bg6jji/MicroTransceiver/README.md

# MicroTransceiver

源项目地址https://github.com/threeme3/usdx

这是3波段电台的源代码，我修改了一些小细节

感谢Guido pe1nnz 以及DL2MAN,WB2CBA等为此项目作出的辛苦努力，并分享给大家。

主要项目如下：
+ 1、定义XMIT键，未来功能可能会定义为其他功能
+ 2、修改LPF继电器波段切换定义
+ 3、增加I/Q输出 和AUDIO切换继电器
+ 4、加入CW TONE音量调节
+ 5、调整编码器速度为2倍速

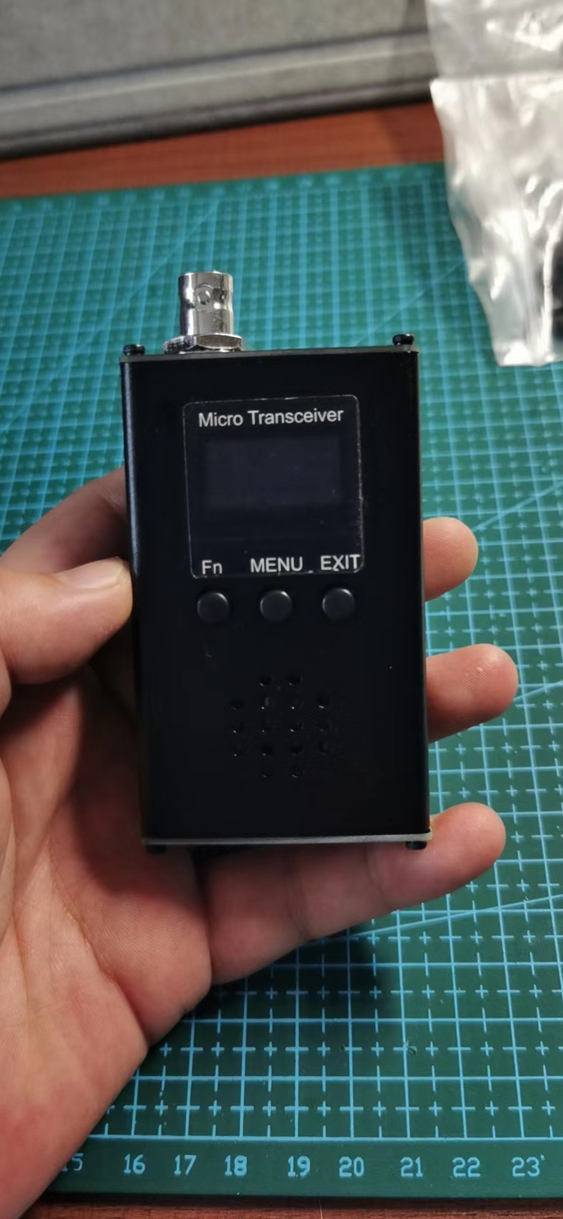
[picture p1: Photo/MicroTransceiver_bnc.jpg]
BNC接口的主机 BNC Connector
