bg6jji/MicroTransceiver/Photo/bottom side.jpg

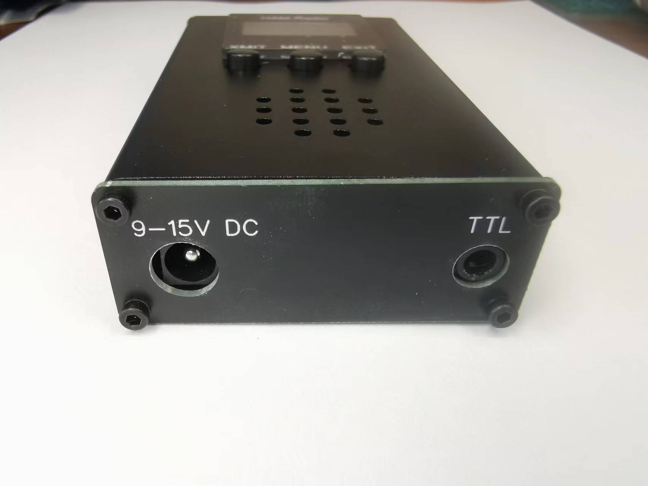
Photo/bottom side.jpg
