bg6jji/MicroTransceiver/Photo/front.jpg

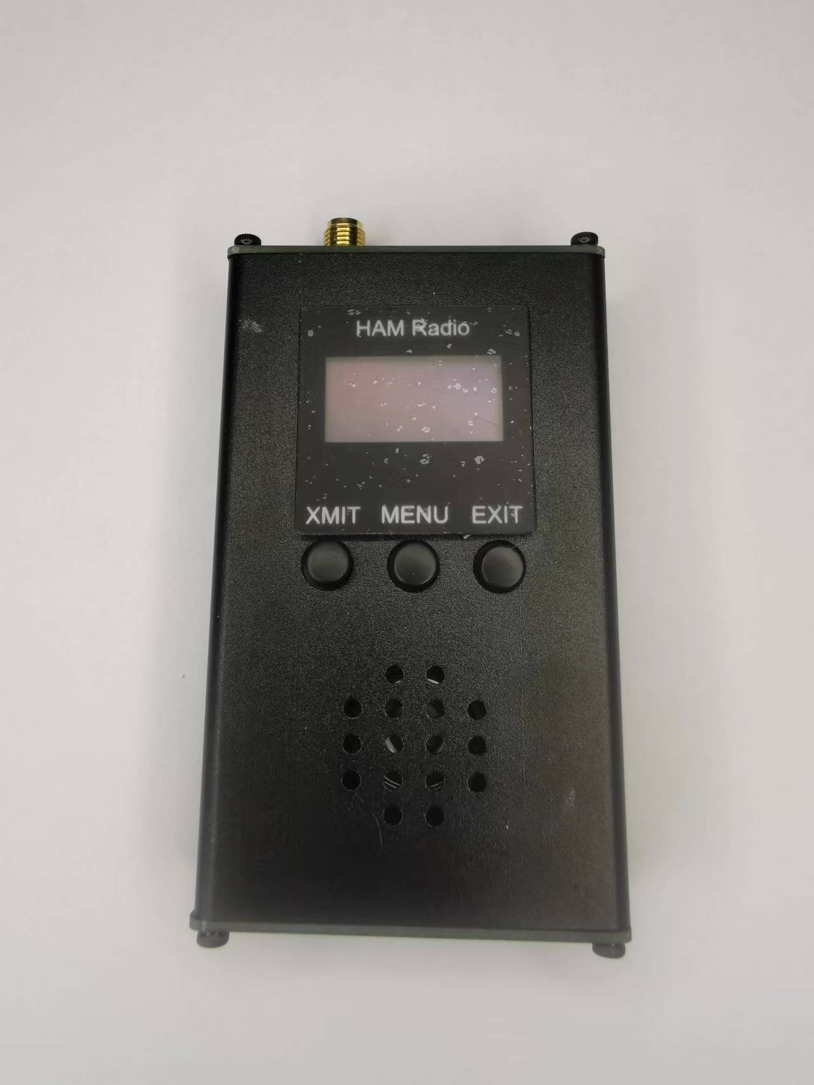
Photo/front.jpg
