bg6jji/MicroTransceiver/Photo/top side.jpg

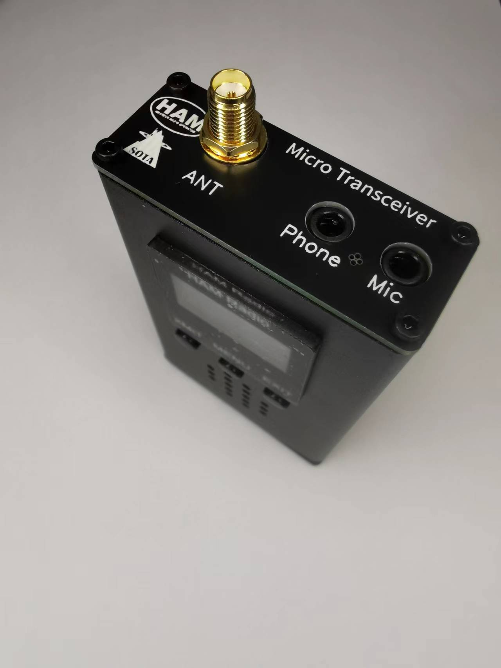
Photo/top side.jpg
