bg6jji/MicroTransceiver/Schematic/Schematic_Micro Transicever V3.3 furband_2022-09-26.pdf

# SI5351A

电源

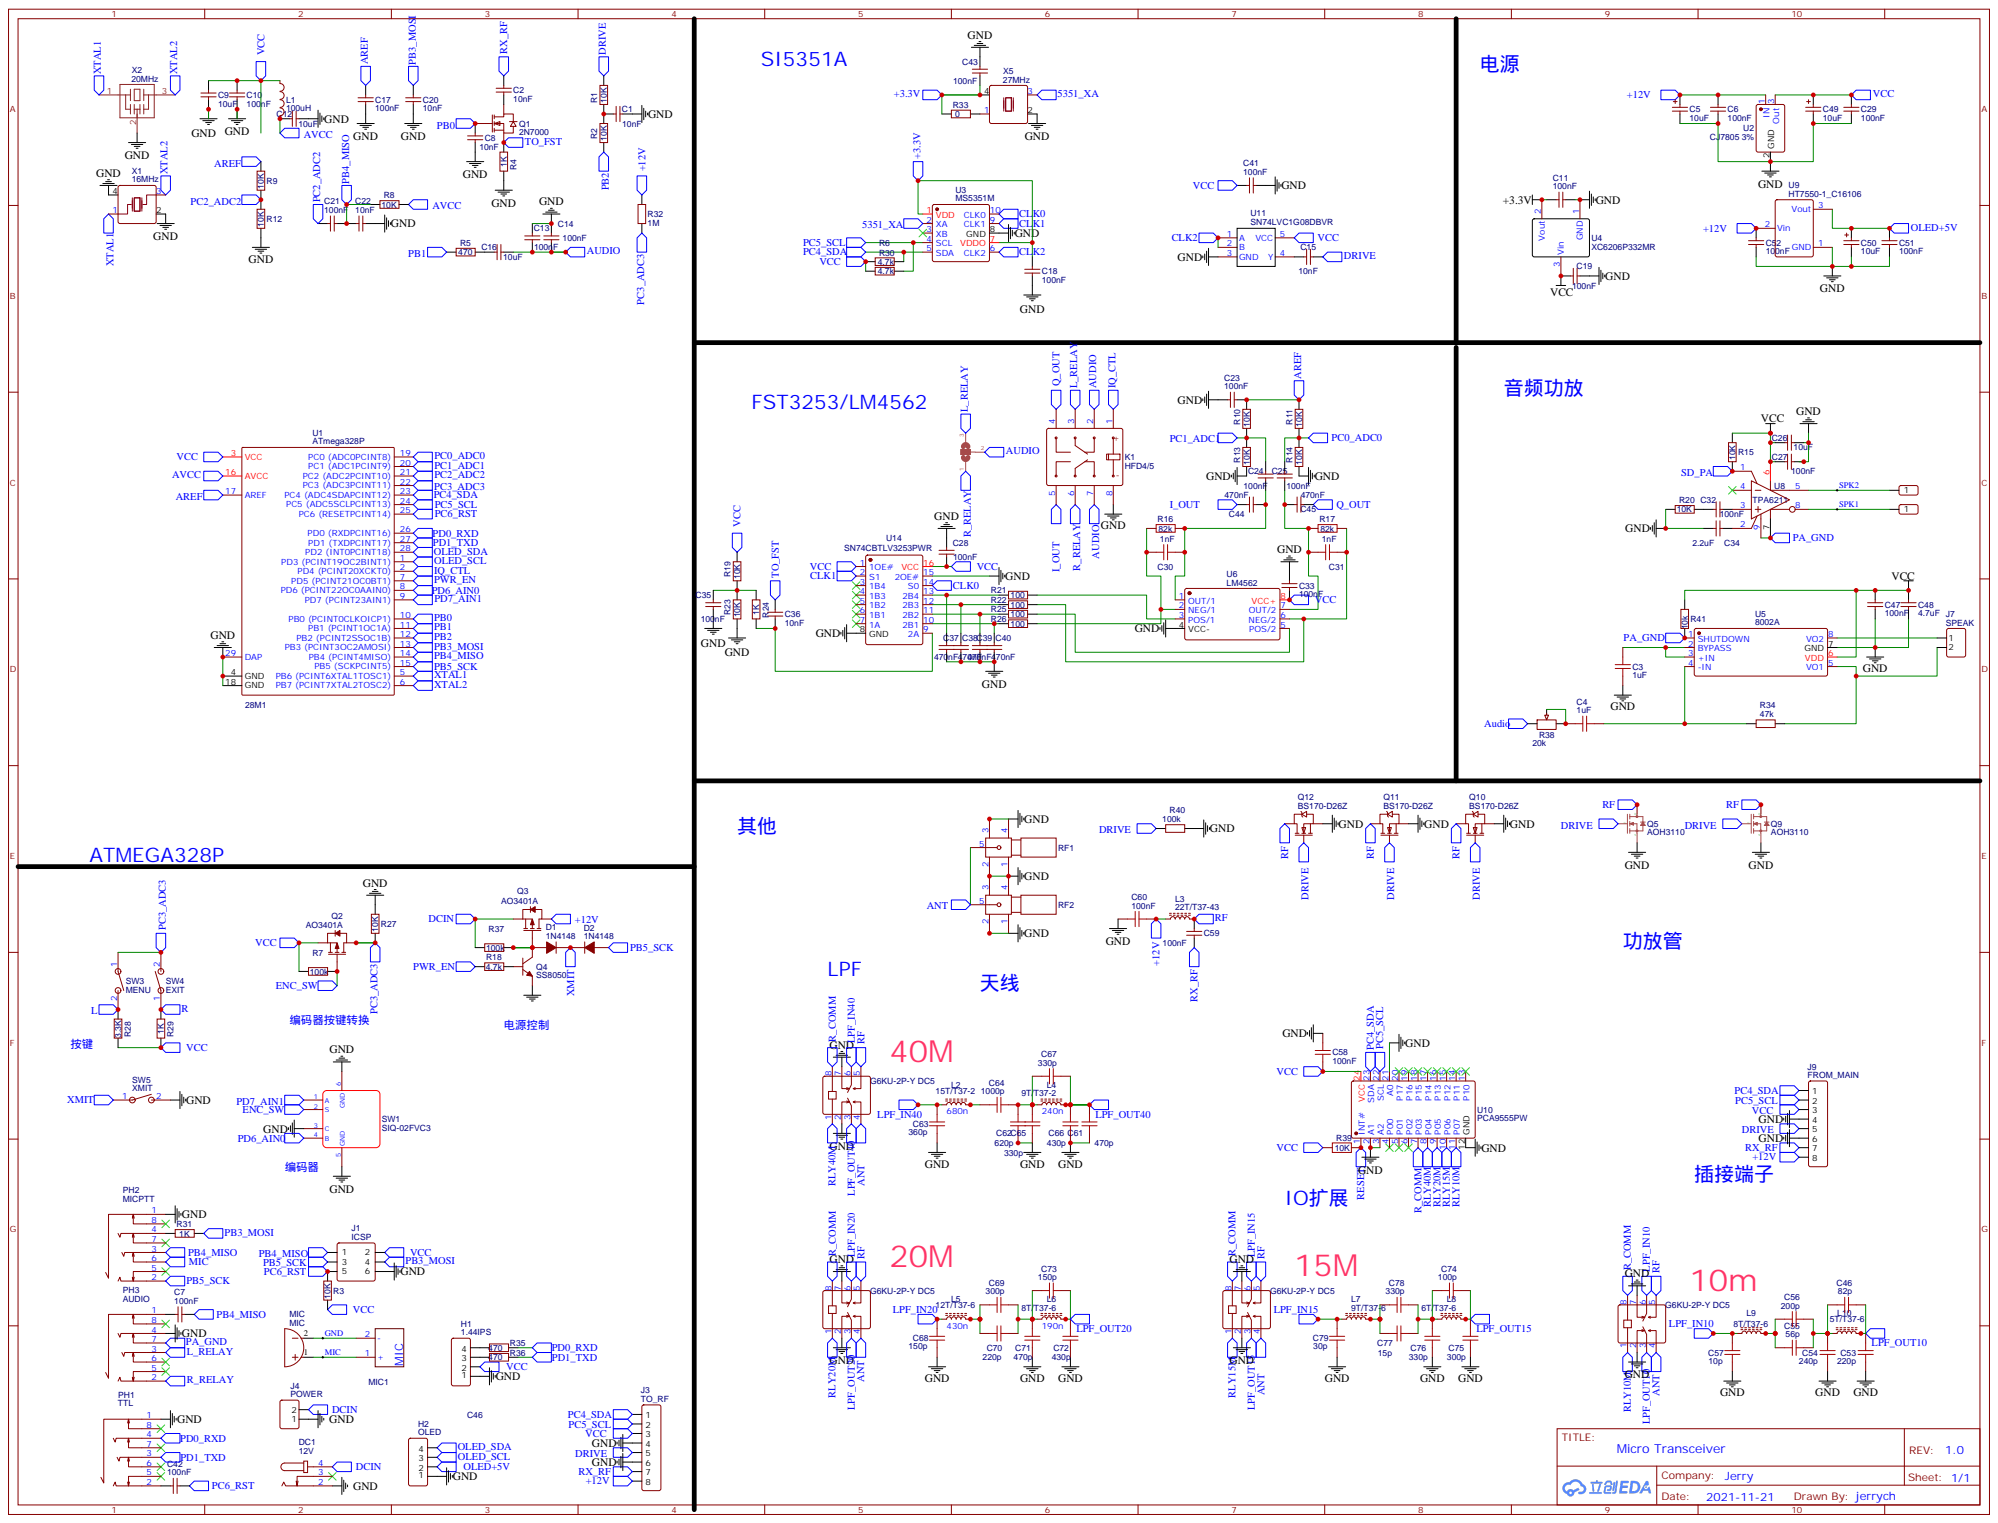
[picture p17: page 1]

GND 12 P10 13 P11 14 P12 15 P13 16 P14 17 P15 18 P16 19 P17 20 A0 21 SCL 22 SDA 23 VCC 24
