bg6jji/MicroTransceiver/Schematic/MicroTransceiver_3band_main_board_Schematic_2022-6-3.pdf

# SI5351A

电源

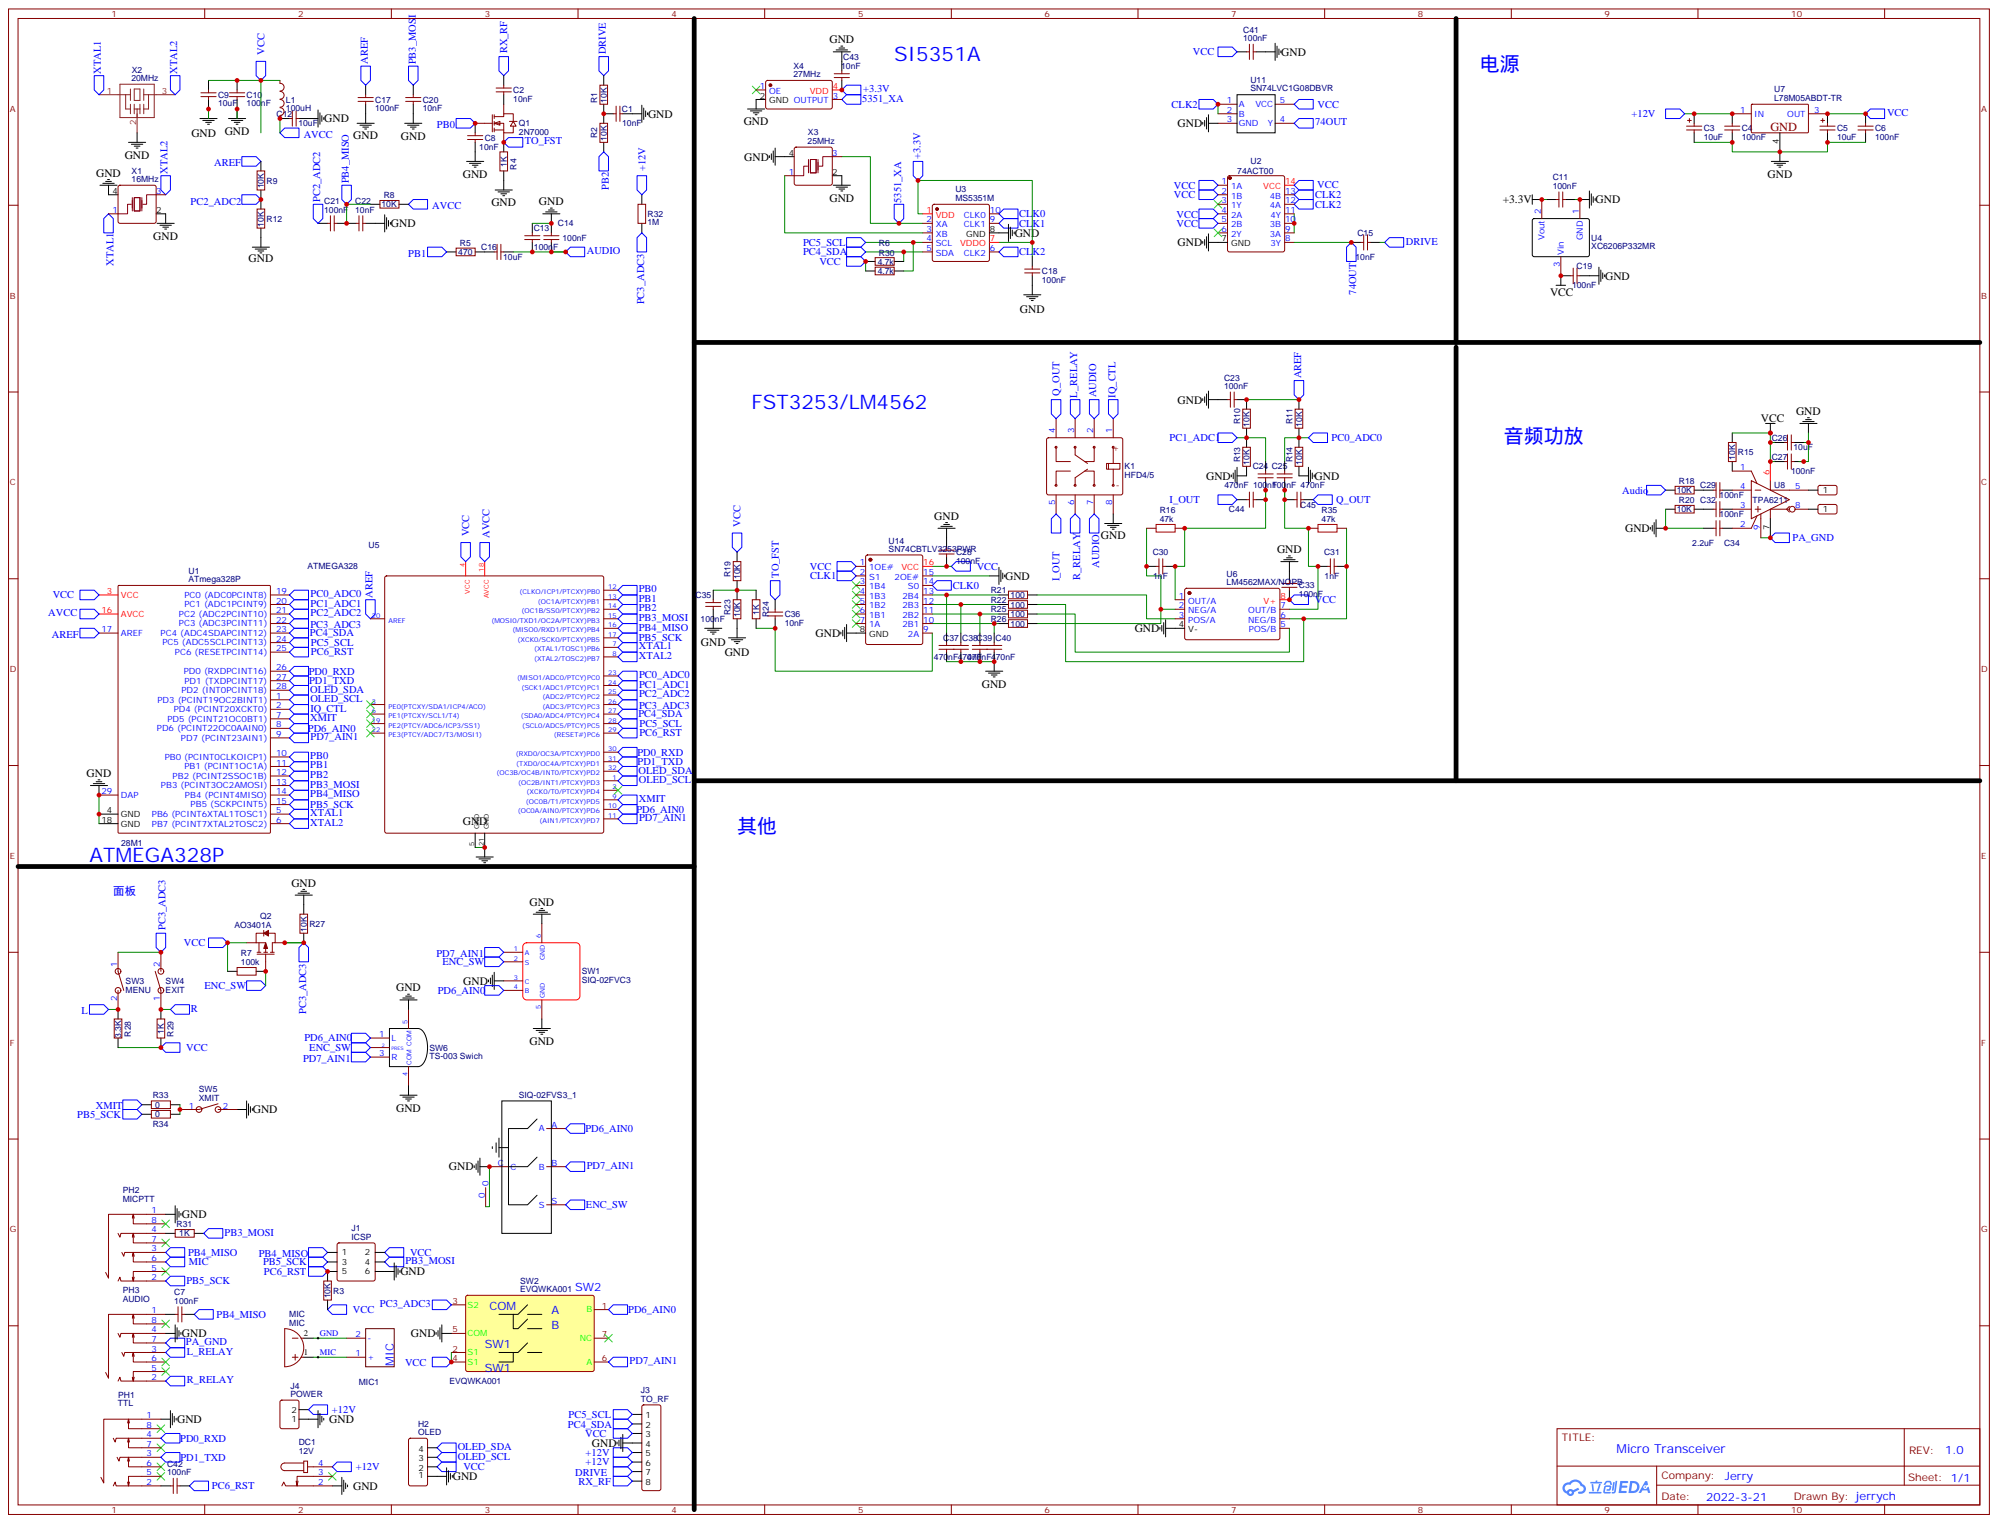
[picture p18: page 1]
