bg6jji/MicroTransceiver/Schematic/MicroTransceiver_3band_RF_board_Schematic_2022-6-3.pdf

20M | 15M | 40M

# 滤波器

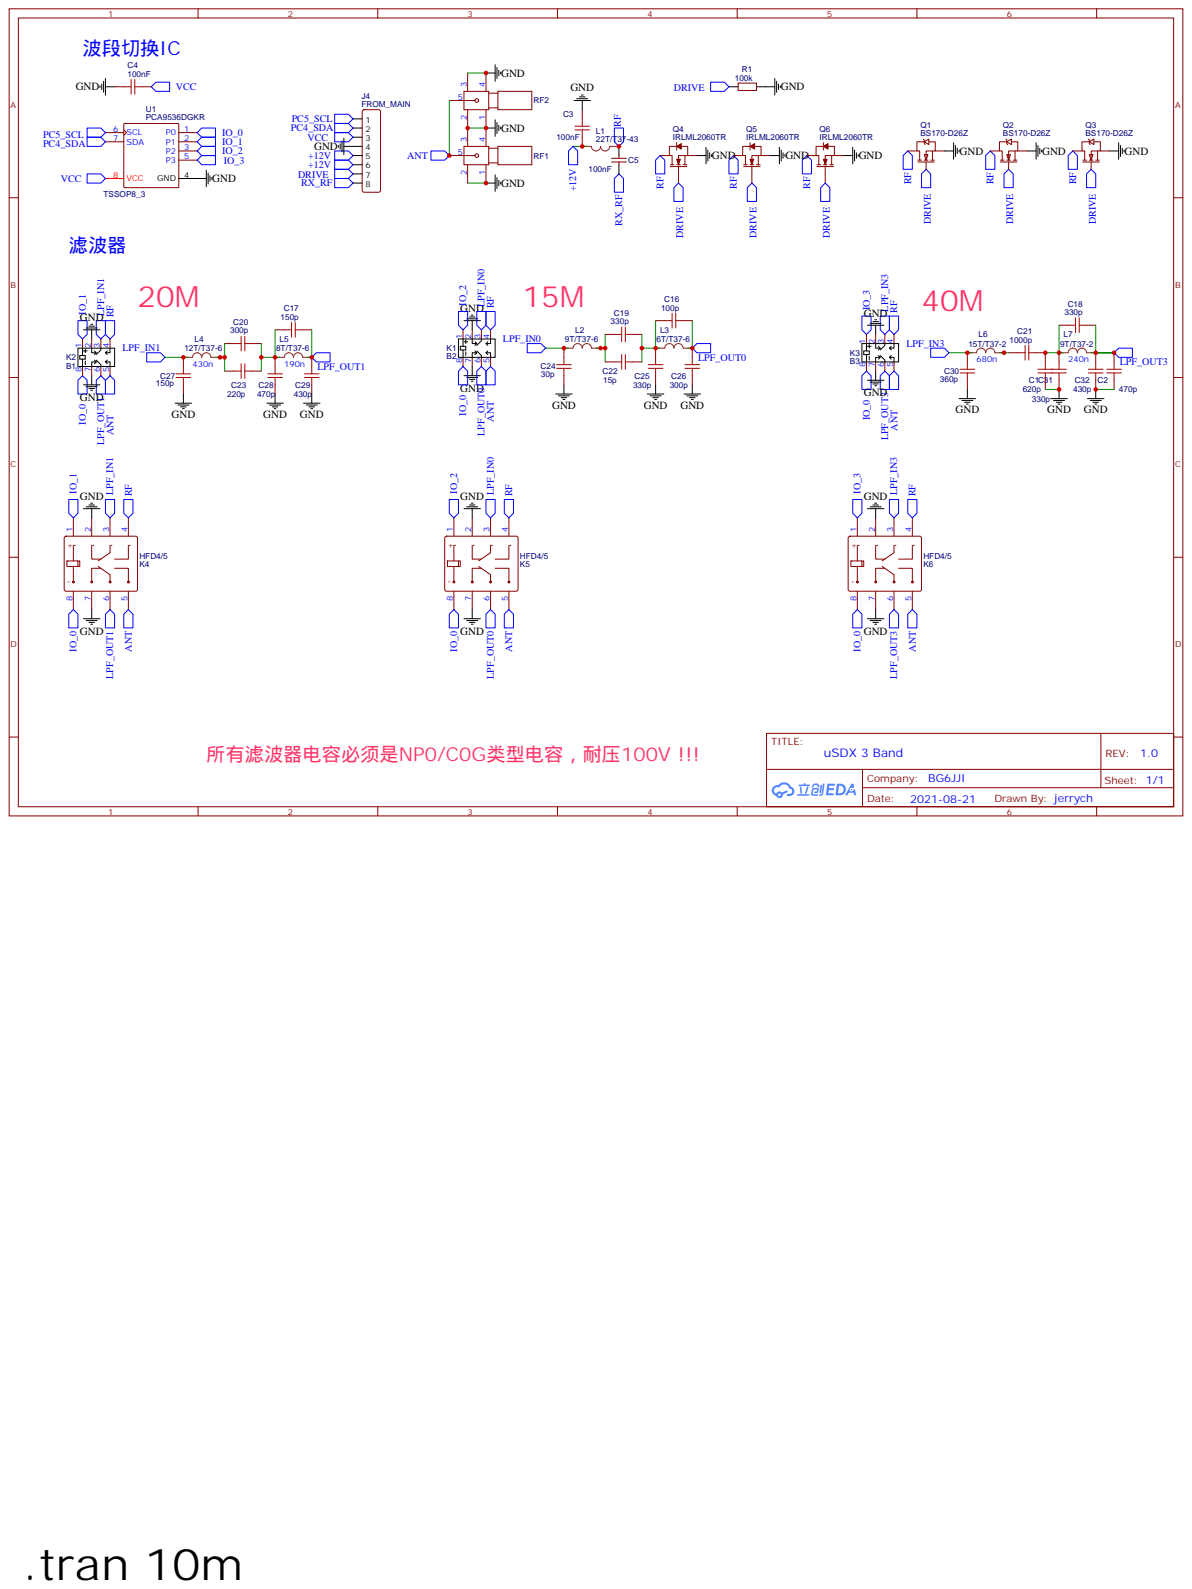
[picture p19: page 1]
