bg6jji/MicroTransceiver/MicroTransceiver3.4.ino

//  QCX-SSB.ino - https://github.com/threeme3/QCX-SSB
//
//  Copyright 2019, 2020, 2021   Guido PE1NNZ <pe1nnz@amsat.org>
//
//  Permission is hereby granted, free of charge, to any person obtaining a copy of this software and associated documentation files (the "Software"), to deal in the Software without restriction, including without limitation the rights to use, copy, modify, merge, publish, distribute, sublicense, and/or sell copies of the Software, and to permit persons to whom the Software is furnished to do so, subject to the following conditions: The above copyright notice and this permission notice shall be included in all copies or substantial portions of the Software. THE SOFTWARE IS PROVIDED "AS IS", WITHOUT WARRANTY OF ANY KIND, EXPRESS OR IMPLIED, INCLUDING BUT NOT LIMITED TO THE WARRANTIES OF MERCHANTABILITY, FITNESS FOR A PARTICULAR PURPOSE AND NONINFRINGEMENT. IN NO EVENT SHALL THE AUTHORS OR COPYRIGHT HOLDERS BE LIABLE FOR ANY CLAIM, DAMAGES OR OTHER LIABILITY, WHETHER IN AN ACTION OF CONTRACT, TORT OR OTHERWISE, ARISING FROM, OUT OF OR IN CONNECTION WITH THE SOFTWARE OR THE USE OR OTHER DEALINGS IN THE SOFTWARE.

#define VERSION   "1.02x"

// Configuration switches; remove/add a double-slash at line-start to enable/disable a feature; to save space disable e.g. CAT, DIAG, KEYER
//#define DIAG             1   // Hardware diagnostics on startup (only disable when your rig is working)
#define KEYER            1   // CW keyer
//#define CAT              1   // CAT-interface
#define F_XTAL  27000000   // 27MHz SI5351 crystal
//#define F_XTAL  25001000   // 25MHz SI5351 crystal  (enable for WB2CBA-uSDX, SI5351 break-out board or uSDXDuO)
//#define F_XTAL  25000000   // 25MHz SI5351 crystal  (enable for 25MHz TCXO)
#define SWAP_ROTARY    1   // Swap rotary direction (enable for WB2CBA-uSDX)
//#define QCX            1   // Supports older (non-SDR) QCX HW modifications (QCX, QCX-SSB, QCX-DSP with I/Q alignment-feature)
#define OLED_SSD1306   1   // OLED display (SSD1306 128x32 or 128x64), connect SDA (PD2), SCL (PD3)
//#define OLED_SH1106    1   // OLED display (SH1106 1.3" inch display), connect SDA (PD2), SCL (PD3), NOTE that this display is pretty slow
//#define LCD_I2C        1   // LCD with I2C (PCF8574 module          ), connect SDA (PD2), SCL (PD3), NOTE that this display is pretty slow
//#define LPF_SWITCHING_DL2MAN_USDX_REV3           1   // Enable 8-band filter bank switching:     latching relays wired to a TCA/PCA9555 GPIO extender on the PC4/PC5 I2C bus; relays are using IO0.0 as common (ground), IO1.0..7 used by the individual latches K0-7 switching respectively LPFs for 10m, 15m, 17m, 20m, 30m, 40m, 60m, 80m
//#define LPF_SWITCHING_DL2MAN_USDX_REV3_NOLATCH 1   // Enable 8-band filter bank switching: non-latching relays wired to a TCA/PCA9555 GPIO extender on the PC4/PC5 I2C bus; relays are using IO0.0 as common (ground), IO1.0..7 used by the individual latches K0-7 switching respectively LPFs for 10m, 15m, 17m, 20m, 30m, 40m, 60m, 80m. Enable this if you are using 8-band non-latching version for the relays, the radio will draw extra 15mA current but will work ity any relay (Tnx OH2UDS/TA7W Baris)
#define LPF_SWITCHING_DL2MAN_USDX_REV2         1   // Enable 5-band filter bank switching:     latching relays wired to a TCA/PCA9555 GPIO extender on the PC4/PC5 I2C bus; relays are using IO0.1 as common (ground), IO0.3, IO0.5, IO0.7, IO1.1, IO1.3 used by the individual latches K1-5 switching respectively LPFs for 20m, 30m, 40m, 60m, 80m
// #define LPF_SWITCHING_DL2MAN_USDX_REV2_BETA    1   // Enable 5-band filter bank switching:     latching relays wired to a PCA9539PW   GPIO extender on the PC4/PC5 I2C bus; relays are using IO0.1 as common (ground), IO0.3, IO0.5, IO0.7, IO1.1, IO1.3 used by the individual latches K1-5 switching respectively LPFs for 20m, 30m, 40m, 60m, 80m
// #define LPF_SWITCHING_DL2MAN_USDX_REV1         1   // Enable 3-band filter bank switching:     latching relays wired to a PCA9536D    GPIO extender on the PC4/PC5 I2C bus; relays are using IO0 as common (ground), IO1-IO3 used by the individual latches K1-3 switching respectively LPFs for 20m, 40m, 80m
//#define LPF_SWITCHING_WB2CBA_USDX_OCTOBAND     1   // Enable 8-band filter bank switching: non-latching relays wired to a MCP23008    GPIO extender on the PC4/PC5 I2C bus; relays are using GND as common (ground), GP0..7 used by the individual latches K1-8 switching respectively LPFs for 80m, 60m, 40m, 30m, 20m, 17m, 15m, 10m
//#define LPF_SWITCHING_PE1DDA_USDXDUO           14  // Enable 2-band filter bank switching: non-latching relay  wired to pin PD5 (pin 11); specify as value the frequency in MHz for which (and above) the relay should be altered (e.g. put 14 to enable the relay at 14MHz and above to use the 20m LPF).
#define SI5351_ADDR   0x60   // SI5351A I2C address: 0x60 for SI5351A-B-GT, Si5351A-B04771-GT, MS5351M; 0x62 for SI5351A-B-04486-GT; 0x6F for SI5351A-B02075-GT; see here for other variants: https://www.silabs.com/TimingUtility/timing-download-document.aspx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
#define F_MCU   16000000   // 16MHz ATMEGA328P crystal (enable for unmodified Arduino Uno/Nano boards with 16MHz crystal). You may change this value to any other crystal frequency (up to 28MHz may work)

// Advanced configuration switches
//#define CONDENSED      1   // Display in 4 line mode (for OLED and LCD2004 modules)
//#define CAT_EXT        1   // Extended CAT support: remote button and screen control commands over CAT
//#define CAT_STREAMING  1   // Extended CAT support: audio streaming over CAT, once enabled and triggered with CAT cmd, samplerate 7812Hz, 8-bit unsigned audio is sent over UART. The ";" is omited in the data-stream, and only sent to indicate the beginning and end of a CAT cmd.
#define CW_DECODER       1   // CW decoder
#define TX_ENABLE        1   // Disable this for RX only (no transmit), e.g. to support uSDX for kids idea: https://groups.io/g/ucx/topic/81030243#6276
#define KEY_CLICK        1   // Reduce key clicks by envelope shaping
#define SEMI_QSK         1   // Just after keying the transmitter, keeps the RX muted for a short amount of time in the anticipation for continued keying
#define RIT_ENABLE       1   // Receive-In-Transit alternates the receiving frequency with an user-defined offset to compensate for any necessary tuning needed on receive
#define VOX_ENABLE       1   // Voice-On-Xmit which is switching the transceiver into transmit as soon audio is detected (above noise gate level)
#define MOX_ENABLE     1   // Monitor-On-Xmit which is audio monitoring on speaker during transmit
#define FAST_AGC       1   // Adds fast AGC option (good for CW)
#define VSS_METER      1   // Supports Vss measurement (as s-meter option), requires resistor of 1M between 12V and pin 26 (PC3)
//#define SWR_METER      1   // Supports SWR meter with bridge on A6/A7 (LQPF ATMEGA328P) by Alain, K1FM, see: https://groups.io/g/ucx/message/6262 and https://groups.io/g/ucx/message/6361
//#define ONEBUTTON      1   // Use single (encoder) button to control full the rig; optionally use L/R buttons to completely replace rotory encoder function
//#define DEBUG          1   // for development purposes only (adds debugging features such as CPU, sample-rate measurement, additional parameters)
//#define TESTBENCH      1   // Tests RX chain by injection of sine wave, measurements results are sent over serial
// #define CW_FREQS_QRP   1   // Defaults to CW QRP   frequencies when changing bands
//#define CW_FREQS_FISTS 1   // Defaults to CW FISTS frequencies when changing bands
#define CW_MESSAGE       1   // Transmits pre-defined CW messages on-demand (left-click menu item 4.2)
//#define CW_MESSAGE_EXT 1   // Additional CW messages
//#define TX_DELAY       1   // Enables a delay in the actual transmission to allow relay-switching to be completed before the power is applied (see also NTX, PTX definitions below for GPIO that can switch relay/PA)
#define NTX            11  // Enables LOW  on TX, used as PTT out to enable external PAs (a value of 11 means PB3 is used)
//#define PTX            11  // Enables HIGH on TX, used as PTT out to enable external PAs (a value of 11 means PB3 is used)
//#define CLOCK          1   // Enables clock
//#define CW_INTERMEDIATE  1   // CW decoder shows intermediate characters (only available for LCD and F_MCU at 20M), sequences like:  EIS[HV] EIUF EAW[JP] EARL TMO TMG[ZQ] TND[BX] TNK[YC], may be good to learn CW; a full list of possible sequences:  EISH5 EISV3 EIUF EIUU2 EAWJ1 EAWP EARL TMOO0 TMOO9 TMOO8 TMGZ7 TMGQ TNDB6 TNDX TNKY TNKC
//#define F_XTAL  20000000   // Enable this for uSDXDuO, 20MHz SI5351 crystal
//#define TX_CLK0_CLK1   1   // Enable this for uSDXDuO, i.e. when PA is driven by CLK0, CLK1 (not CLK2); NTX pin may be used for enabling the TX path (this is like RX pin, except that RX may also be used as attenuator)
//#define F_CLK2  12000000   // Enables a fixed CLK2 clock output of choice (only applicable when TX_CLK0_CLK1 is enabled), e.g. for up-converter or to clock UART USB device



// QCX pin defintions
#define LCD_D4  0         //PD0    (pin 2)
#define LCD_D5  1         //PD1    (pin 3)
#define LCD_D6  2         //PD2    (pin 4)
#define LCD_D7  3         //PD3    (pin 5)
#define LCD_EN  4         //PD4    (pin 6)
#define FREQCNT 5         //PD5    (pin 11)
#define ROT_A   6         //PD6    (pin 12)
#define ROT_B   7         //PD7    (pin 13)
#define RX      8         //PB0    (pin 14)
#define SIDETONE 9        //PB1    (pin 15)
#define KEY_OUT 10        //PB2    (pin 16)
#define SIG_OUT 11        //PB3    (pin 17)
#define DAH     12        //PB4    (pin 18)
#define DIT     13        //PB5    (pin 19)
#define AUDIO1  15        //PC0/A0 (pin 23)
#define AUDIO2  14        //PC1/A1 (pin 24)
#define DVM     16        //PC2/A2 (pin 25)
#define BUTTONS 17        //PC3/A3 (pin 26)
#define LCD_RS  18        //PC4    (pin 27)
#define SDA     18        //PC4    (pin 27)
#define SCL     19        //PC5    (pin 28)
//#define NTX   11        //PB3    (pin 17)
//#define PTX   11        //PB3    (pin 17)

#define XMIT     5        //PD5    
#define IQOUT   4         //PD4    
#ifdef SWAP_ROTARY
#undef ROT_A
#undef ROT_B
#define ROT_A   7         //PD7    (pin 13)
#define ROT_B   6         //PD6    (pin 12)
#endif

#if (defined(OLED_SSD1306) || defined(OLED_SH1106))
#define OLED    1
#endif

#if (defined(CAT) || defined(TESTBENCH)) && !(OLED)
#define _SERIAL  1       // Coexistence support for serial port and LCD on the same pins
#endif

#ifdef LPF_SWITCHING_DL2MAN_USDX_REV3_NOLATCH
#define LPF_SWITCHING_DL2MAN_USDX_REV3         1
#endif

#ifdef TX_CLK0_CLK1
#ifdef F_CLK2
#define TX1RX0  0b11111000
#define TX1RX1  0b11111000
#define TX0RX1  0b11111000
#define TX0RX0  0b11111011
#else //!F_CLK2
#define TX1RX0  0b11111100
#define TX1RX1  0b11111100
#define TX0RX1  0b11111100
#define TX0RX0  0b11111111
#endif //F_CLK2
#else  //!TX_CLK0_CLK1
#define TX1RX0  0b11111011
#define TX1RX1  0b11111000
#define TX0RX1  0b11111100
#define TX0RX0  0b11111111
#endif //TX_CLK0_CLK1

#if defined(F_CLK2) && !defined(TX_CLK0_CLK1)
#error "TX_CLK0_CLK1 must be enabled in order to use F_CLK2."
#endif

#ifndef TX_ENABLE
#undef KEYER
#undef TX_DELAY
#undef SEMI_QSK
#undef RIT_ENABLE
#undef VOX_ENABLE
#undef MOX_ENABLE
#endif //!TX_ENABLE

#ifdef SWR_METER
float FWD;
float SWR;
float ref_V = 5 * 1.15;
static uint32_t stimer;
#define PIN_FWD  A6
#define PIN_REF  A7
#endif

/*
  // UCX installation: On blank chip, use (standard Arduino Uno) fuse settings (E:FD, H:DE, L:FF), and use customized Optiboot bootloader for 20MHz clock, then upload via serial interface (with RX, TX and DTR lines connected to pin 1, 2, 3 respectively)
  // UCX pin defintions
  +#define SDA     3         //PD3    (pin 5)
  +#define SCL     4         //PD4    (pin 6)
  +#define ROT_A   6         //PD6    (pin 12)
  +#define ROT_B   7         //PD7    (pin 13)
  +#define RX      8         //PB0    (pin 14)
  +#define SIDETONE 9        //PB1    (pin 15)
  +#define KEY_OUT 10        //PB2    (pin 16)
  +#define NTX     11        //PB3    (pin 17)
  +#define DAH     12        //PB4    (pin 18)
  +#define DIT     13        //PB5    (pin 19)
  +#define AUDIO1  14        //PC0/A0 (pin 23)
  +#define AUDIO2  15        //PC1/A1 (pin 24)
  +#define DVM     16        //PC2/A2 (pin 25)
  +#define BUTTONS 17        //PC3/A3 (pin 26)
  // In addition set:
  #define OLED  1
  #define ONEBUTTON  1
  #define ONEBUTTON_INV 1
  #undef DEBUG
  adjust I2C and I2C_ ports,
  ssb_cap=1; dsp_cap=2;
  #define _DELAY() for(uint8_t i = 0; i != 5; i++) asm("nop");
  #define F_XTAL 20004000
  #define F_CPU F_XTAL
*/

//FUSES = { .low = 0xFF, .high = 0xD6, .extended = 0xFD };   // Fuse settings should be set at programming (Arduino IDE > Tools > Burn bootloader)

#if(ARDUINO < 10810)
#error "Unsupported Arduino IDE version, use Arduino IDE 1.8.10 or later from https://www.arduino.cc/en/software"
#endif
#if !(defined(ARDUINO_ARCH_AVR))
#error "Unsupported architecture, select Arduino IDE > Tools > Board > Arduino AVR Boards > Arduino Uno."
#endif
//#if(F_CPU != 16000000)
//   #error "Unsupported clock frequency, Arduino IDE must specify 16MHz clock; alternate crystal frequencies may be specified with F_MCU."
//#endif
#undef F_CPU
#define F_CPU 20007000  // Actual crystal frequency of 20MHz XTAL1, note that this declaration is just informative and does not correct the timing in Arduino functions like delay(); hence a 1.25 factor needs to be added for correction.
#ifndef F_MCU
#define F_MCU 20000000  // 20MHz ATMEGA328P crystal
#endif

extern char __bss_end;
static int freeMemory() {
  char* sp = reinterpret_cast<char*>(SP);  // see: http://www.nongnu.org/avr-libc/user-manual/malloc.html
  return sp - &__bss_end;
}

#ifdef CAT_EXT
volatile uint8_t cat_key = 0;
uint8_t _digitalRead(uint8_t pin) { // reads pin or (via CAT) artificially overriden pins
  serialEvent();  // allows CAT update
  if (cat_key) {
    return (pin == BUTTONS) ? ((cat_key & 0x07) > 0) : (pin == DIT) ? ~cat_key & 0x10 : (pin == DAH) ? ~cat_key & 0x20 : 0;  // overrides digitalRead(DIT, DAH, BUTTONS);
  }
  return digitalRead(pin);
}
#else
#define _digitalRead(x) digitalRead(x)
#endif //CAT_EXT

//#define ONEBUTTON_INV 1 // Encoder button goes from PC3 to GND (instead PC3 to 5V, with 10k pull down)
#ifdef ONEBUTTON_INV
uint8_t inv = 1;
#else
uint8_t inv = 0;
#endif

//#ifdef KEYER
// Iambic Morse Code Keyer Sketch, Contribution by Uli, DL2DBG. Copyright (c) 2009 Steven T. Elliott Source: http://openqrp.org/?p=343,  Trimmed by Bill Bishop - wrb[at]wrbishop.com.  This library is free software; you can redistribute it and/or modify it under the terms of the GNU Lesser General Public License as published by the Free Software Foundation; either version 2.1 of the License, or (at your option) any later version. This library is distributed in the hope that it will be useful, but WITHOUT ANY WARRANTY; without even the implied warranty of MERCHANTABILITY or FITNESS FOR A PARTICULAR PURPOSE.  See the GNU Lesser General Public License for more details: Free Software Foundation, Inc., 59 Temple Place, Suite 330, Boston, MA  02111-1307  USA.

// keyerControl bit definitions
#define DIT_L    0x01     // Dit latch
#define DAH_L    0x02     // Dah latch
#define DIT_PROC 0x04     // Dit is being processed
#define PDLSWAP  0x08     // 0 for normal, 1 for swap
#define IAMBICB  0x10     // 0 for Iambic A, 1 for Iambic B
#define IAMBICA  0x00     // 0 for Iambic A, 1 for Iambic B
#define SINGLE   2        // Keyer Mode 0 1 -> Iambic2  2 ->SINGLE

int keyer_speed = 25;
static unsigned long ditTime;                    // No. milliseconds per dit
static uint8_t keyerControl;
static uint8_t keyerState;
static uint8_t keyer_mode = 2; //->  SINGLE
static uint8_t keyer_swap = 0; //->  DI/DAH

static uint32_t ktimer;
static int Key_state;
int debounce;

enum KSTYPE {IDLE, CHK_DIT, CHK_DAH, KEYED_PREP, KEYED, INTER_ELEMENT }; // State machine states

void update_PaddleLatch() // Latch dit and/or dah press, called by keyer routine
{
  if (_digitalRead(DIT) == LOW) {
    keyerControl |= keyer_swap ? DAH_L : DIT_L;
  }
  if (_digitalRead(DAH) == LOW) {
    keyerControl |= keyer_swap ? DIT_L : DAH_L;
  }
}

void loadWPM (int wpm) // Calculate new time constants based on wpm value
{
#if(F_MCU != 20000000)
  ditTime = (1200ULL * F_MCU / 16000000) / wpm; //ditTime = 1200/wpm;  compensated for F_CPU clock (running in a 16MHz Arduino environment)
#else
  ditTime = (1200 * 5 / 4) / wpm; //ditTime = 1200/wpm;  compensated for 20MHz clock (running in a 16MHz Arduino environment)
#endif
}
//#endif //KEYER
static uint8_t practice = false;  // Practice mode

volatile uint8_t cat_active = 0;
volatile uint32_t rxend_event = 0;
volatile uint8_t vox = 0;

#include <avr/sleep.h>
#include <avr/wdt.h>

//#define _I2C_DIRECT_IO    1 // Enables communications that is not using the standard I/O pull-down approach with pull-up resistors, instead I/O is directly driven with 0V/5V
class I2C_ { // Secundairy I2C class used by I2C LCD/OLED, uses alternate pins: PD2 (SDA) and PD3 (SCL)
  public:

#if(F_MCU > 20900000)
#ifdef OLED_SH1106
#define _DELAY() for(uint8_t i = 0; i != 9; i++) asm("nop");
#else
#ifdef OLED_SSD1306
#define _DELAY() for(uint8_t i = 0; i != 6; i++) asm("nop");
#else // other (I2C_LCD)
#define _DELAY() for(uint8_t i = 0; i != 7; i++) asm("nop");
#endif
#endif
#else // slow F_MCU
#ifdef OLED_SH1106
#define _DELAY() for(uint8_t i = 0; i != 8; i++) asm("nop");
#else
#ifdef OLED_SSD1306
#define _DELAY() for(uint8_t i = 0; i != 4; i++) asm("nop"); // 4=731kb/s
#else // other (I2C_LCD)
#define _DELAY() for(uint8_t i = 0; i != 5; i++) asm("nop");
#endif
#endif
#endif // F_MCU
#define _I2C_SDA (1<<2) // PD2
#define _I2C_SCL (1<<3) // PD3
#ifdef _I2C_DIRECT_IO
#define _I2C_INIT() _I2C_SDA_HI(); _I2C_SCL_HI(); DDRD |= (_I2C_SDA | _I2C_SCL);  // direct I/O (no need for pull-ups)
#define _I2C_SDA_HI() PORTD |=  _I2C_SDA;
#define _I2C_SDA_LO() PORTD &= ~_I2C_SDA;
#define _I2C_SCL_HI() PORTD |=  _I2C_SCL; _DELAY();
#define _I2C_SCL_LO() PORTD &= ~_I2C_SCL; _DELAY();
#else // !_I2C_DIRECT_IO
#define _I2C_INIT()   PORTD &= ~_I2C_SDA; PORTD &= ~_I2C_SCL; _I2C_SDA_HI(); _I2C_SCL_HI();  // open-drain
#define _I2C_SDA_HI() DDRD &= ~_I2C_SDA;
#define _I2C_SDA_LO() DDRD |=  _I2C_SDA;
#define _I2C_SCL_HI() DDRD &= ~_I2C_SCL; _DELAY();
#define _I2C_SCL_LO() DDRD |=  _I2C_SCL; _DELAY();
#endif // !_I2C_DIRECT_IO
#define _I2C_START() _I2C_SDA_LO(); _DELAY(); _I2C_SCL_LO(); // _I2C_SDA_HI();
#define _I2C_STOP()  _I2C_SDA_LO(); _I2C_SCL_HI(); _I2C_SDA_HI();
#define _I2C_SUSPEND() //_I2C_SDA_LO(); // SDA_LO to allow re-use as output port
#define _SendBit(data, bit) \
  if(data & 1 << bit){ \
    _I2C_SDA_HI();  \
  } else {         \
    _I2C_SDA_LO();  \
  }                \
  _I2C_SCL_HI();    \
  _I2C_SCL_LO();
    inline void start() {
      _I2C_INIT();
      _I2C_START();
    };
    inline void stop() {
      _I2C_STOP();
      _I2C_SUSPEND();
    };
    inline void SendByte(uint8_t data) {
      _SendBit(data, 7);
      _SendBit(data, 6);
      _SendBit(data, 5);
      _SendBit(data, 4);
      _SendBit(data, 3);
      _SendBit(data, 2);
      _SendBit(data, 1);
      _SendBit(data, 0);
      _I2C_SDA_HI();  // recv ACK
      _DELAY(); //
      _I2C_SCL_HI();
      _I2C_SCL_LO();
    }
    void SendRegister(uint8_t addr, uint8_t* data, uint8_t n) {
      start();
      SendByte(addr << 1);
      while (n--) SendByte(*data++);
      stop();
    }
    //void SendRegister(uint8_t addr, uint8_t val){ SendRegister(addr, &val, 1); }

    void begin() {};
    void beginTransmission(uint8_t addr) {
      start();
      SendByte(addr << 1);
    };
    bool write(uint8_t byte) {
      SendByte(byte);
      return 1;
    };
    uint8_t endTransmission() {
      stop();
      return 0;
    };
};
I2C_ Wire;
//#include <Wire.h>

uint8_t backlight = 8; 
//#define RS_HIGH_ON_IDLE   1   // Experimental LCD support where RS line is high on idle periods to comply with SDA I2C standard.

class LCD : public Print {  // inspired by: http://www.technoblogy.com/show?2BET
  public:  // LCD1602 display in 4-bit mode, RS is pull-up and kept low when idle to prevent potential display RFI via RS line
#define _dn  0      // PD0 to PD3 connect to D4 to D7 on the display
#define _en  4      // PD4 - MUST have pull-up resistor
#define _rs  4      // PC4 - MUST have pull-up resistor
#define RS_PULLUP  1   // Use pullup on RS line, ensures compliancy to the absolute maximum ratings for the si5351 sda input that is shared with rs pin of lcd
#ifdef RS_PULLUP
#define LCD_RS_HI() DDRC &= ~(1 << _rs); asm("nop"); // RS high (pull-up)
#define LCD_RS_LO() DDRC |= 1 << _rs;                // RS low (pull-down)
#else
#define LCD_RS_LO() PORTC &= ~(1 << _rs);        // RS low
#define LCD_RS_HI() PORTC |= (1 << _rs);         // RS high
#endif //RS_PULLUP
#define LCD_EN_LO() PORTD &= ~(1 << _en);        // EN low
#define LCD_EN_HI() PORTD |= (1 << _en);         // EN high
#define LCD_PREP_NIBBLE(b) (PORTD & ~(0xf << _dn)) | (b) << _dn | 1 << _en // Send data and enable high
    uint8_t _cols;
    void begin(uint8_t x = 0, uint8_t y = 0) {       // Send command , make sure at least 40ms after power-up before sending commands
      //bool reinit = (x == 0) && (y == 0);
#ifdef LCD_I2C
#define PCF_ADDR  0x27                         // LCD I2C address where PCF8574 addess selection A0, A1, A2 are all open
#define PCF_RS 0x01
#define PCF_RW 0x02  // the 0xF0 bits are used for 4-bit data to the display.
#define PCF_EN 0x04
#define PCF_BACKLIGHT 0x08
      Wire.beginTransmission(PCF_ADDR);
      Wire.write(0);
      Wire.endTransmission();
      delayMicroseconds(50000);
#else //!LCD_I2C
      DDRD |= 0xf << _dn | 1 << _en;                 // Make data, EN outputs
      DDRC |= 1 << _rs;
      //PORTC &= ~(1 << _rs);                          // Set RS low in case to support pull-down when DDRC is output
      delayMicroseconds(50000);                      // *
      LCD_RS_LO(); LCD_EN_LO();
#endif //!LCD_I2C
      cmd(0x33);                                     // Ensures display is in 8-bit mode
      delayMicroseconds(4500); cmd(0x33); delayMicroseconds(4500); cmd(0x33); delayMicroseconds(150); // * Ensures display is in 8-bit mode
      cmd(0x32);                                     // Puts display in 4-bit mode
      cmd(0x28);                                     // * Function set: 2-line, 5x8
      cmd(0x0c);                                     // Display on
      //if(reinit) return;
      cmd(0x01);                                     // Clear display
      delay(3);                                      // Allow to execute Clear on display [https://www.sparkfun.com/datasheets/LCD/HD44780.pdf, p.49, p58]
      cmd(0x06);                                     // * Entrymode: left, shift-dec
    }
#ifdef LCD_I2C
    void nib(uint8_t b, bool isData) {                            // Send four bit nibble to display
      b = (b << 4) | ((backlight) ? PCF_BACKLIGHT : 0) | ((isData) ?  PCF_RS : 0);
      Wire.write(b | PCF_EN);  // write command EN HI
      delayMicroseconds(4);    // enable pulse must be >450ns
      Wire.write(b);           // write command EN LO
      delayMicroseconds(60);   // commands need > 37us to settle
      Wire.write(b);           // must write for some unknown reason
    }
    void cmd(uint8_t b) {
      Wire.beginTransmission(PCF_ADDR);
      nib(b >> 4, false); nib(b, false);
      Wire.endTransmission();
    }
    size_t write(uint8_t b) {
      Wire.beginTransmission(PCF_ADDR);
      nib((b >> 4), true); nib((b), true);
      Wire.endTransmission();
    }
#else //!LCD_I2C
    // Since LCD is using PD0(RXD), PD1(TXD) pins in the data-path, some co-existence feature is required when using the serial port.
    // The following functions are temporarily dsiabling the serial port when LCD writes happen, and make sure that serial transmission is ended.
    // To prevent that LCD writes are received by the serial receiver, PC2 is made HIGH during writes to pull-up TXD via a diode.
    // The RXD, TXD lines are connected to the host via 1k resistors, a 1N4148 is placed between PC2 (anode) and the TXD resistor.
    // There are two drawbacks when continuous LCD writes happen: 1. noise is leaking via the AREF pull-ups into the receiver 2. serial data cannot be received.
    void pre() {
#ifdef _SERIAL
      if (!vox) if (cat_active) {
          Serial.flush();
          for (; millis() < rxend_event;)wdt_reset();
          PORTC |= 1 << 2;
          DDRC |= 1 << 2;
        } UCSR0B &= ~((1 << RXEN0) | (1 << TXEN0)); // Complete serial TX and RX; mask PD1 LCD data-exchange by pulling-up TXD via PC2 HIGH; enable PD0/PD1, disable serial port
#endif
      noInterrupts();  // do not allow LCD tranfer to be interrupted, to prevent backlight to lighten-up
    }
    void post() {
//      if (backlight) PORTD |= 0x08; else PORTD &= ~0x08;  // Backlight control 背光控制
#ifdef _SERIAL
      //UCSR0B |= (1<<RXEN0)|(1<<TXEN0); if(!vox) if(cat_active){ DDRC &= ~(1<<2); } // Enable serial port, disable PD0, PD1; disable PC2
      UCSR0B |= (1 << RXEN0) | (1 << TXEN0); if (!vox) if (cat_active) {
          PORTC &= ~(1 << 2);  // Enable serial port, disable PD0, PD1; PC2 LOW to prevent CAT TX disruption via MIC input
        }
#endif
      interrupts();
    }
#ifdef RS_HIGH_ON_IDLE
    void cmd(uint8_t b) {
      pre();
      uint8_t nibh = LCD_PREP_NIBBLE(b >>  4);       // Prepare high nibble data and enable high
      PORTD = nibh;                                  // Send high nibble data and enable high
      uint8_t nibl = LCD_PREP_NIBBLE(b & 0xf);       // Prepare low nibble data and enable high
      LCD_RS_LO();
      LCD_EN_LO();
      PORTD = nibl;                                  // Send low nibble data and enable high
      asm("nop"); asm("nop");                        // Keep RS low, but complete enable cycle (should be 500ns)
      LCD_EN_LO();
      LCD_RS_HI();
      post();
      delayMicroseconds(60);                         // Execution time  (37+4)*1.25 us
    }
    size_t write(uint8_t b) {                        // Write data:    send nibbles while RS high
      pre();
      uint8_t nibh = LCD_PREP_NIBBLE(b >>  4);       // Prepare high nibble data and enable high
      PORTD = nibh;                                  // Send high nibble data and enable high
      uint8_t nibl = LCD_PREP_NIBBLE(b & 0xf);       // Prepare low nibble data and enable high
      LCD_RS_HI();
      LCD_EN_LO();
      PORTD = nibl;                                  // Send low nibble data and enable high
      asm("nop"); asm("nop");                        // Keep RS high, but complete enable cycle (should be 500ns)
      LCD_EN_LO();
      post();
      delayMicroseconds(60);                         // Execution time  (37+4)*1.25 us
      return 1;
    }
#else //!RS_HIGH_ON_IDLE
    void nib(uint8_t b) {                            // Send four bit nibble to display
      pre();
      PORTD = LCD_PREP_NIBBLE(b);                    // Send data and enable high
      //asm("nop");                                    // Enable high pulse width must be at least 230ns high, data-setup time 80ns
      delayMicroseconds(4);
      LCD_EN_LO();
      post();
      //delayMicroseconds(52);                         // Execution time
      delayMicroseconds(60);                         // Execution time
    }
    void cmd(uint8_t b) {
      nib(b >> 4);  // Write command: send nibbles while RS low
      nib(b & 0xf);
    }
    size_t write(uint8_t b) {                        // Write data:    send nibbles while RS high
      pre();
      //LCD_EN_HI();                                   // Complete Enable cycle must be at least 500ns (so start early)
      uint8_t nibh = LCD_PREP_NIBBLE(b >>  4);       // Prepare high nibble data and enable high
      PORTD = nibh;                                  // Send high nibble data and enable high
      uint8_t nibl = LCD_PREP_NIBBLE(b & 0xf);       // Prepare low nibble data and enable high
      //asm("nop");                                    // Enable high pulse width must be at least 230ns high, data-setup time 80ns; ATMEGA clock-cycle is 50ns (so at least 5 cycles)
      LCD_RS_HI();
      LCD_EN_LO();
      PORTD = nibl;                                  // Send low nibble data and enable high
      LCD_RS_LO();
      //asm("nop"); asm("nop");                        // Complete Enable cycle must be at least 500ns
      //PORTD = nibl;                                  // Send low nibble data and enable high
      //asm("nop");                                    // Enable high pulse width must be at least 230ns high, data-setup time 80ns; ATMEGA clock-cycle is 50ns (so at least 5 cycles)
      LCD_RS_HI();
      LCD_EN_LO();
      LCD_RS_LO();
      post();
      delayMicroseconds(60);                         // Execution time  (37+4)*1.25 us
      return 1;
    }
#endif // RS_HIGH_ON_IDLE
#endif //!LCD_I2C
#ifdef CONDENSED
    void setCursor(uint8_t x, uint8_t y) {
      cmd(0x80 | (x + (uint8_t[]) {
        0x00, 0x40, 0x00 + 20, 0x40 + 20
      }[y]));  // ONLY for LCD2004 display
    }
#else
    void setCursor(uint8_t x, uint8_t y) {
      cmd(0x80 | (x + y * 0x40));
    }
#endif
    void cursor() {
      cmd(0x0e);
    }
    void noCursor() {
      cmd(0x0c);
    }
    void noDisplay() {
      cmd(0x08);
    }
    void createChar(uint8_t l, uint8_t glyph[]) {
      cmd(0x40 | ((l & 0x7) << 3));
      for (int i = 0; i != 8; i++) write(glyph[i]);
    }
};

/*
  class LCD : public Print {  // inspired by: http://www.technoblogy.com/show?2BET
  public:  // LCD1602 display in 4-bit mode, RS is pull-up and kept low when idle to prevent potential display RFI via RS line
  #define _dn  0      // PD0 to PD3 connect to D4 to D7 on the display
  #define _en  4      // PC4 - MUST have pull-up resistor
  #define _rs  4      // PC4 - MUST have pull-up resistor
  #define LCD_RS_HI() DDRC &= ~(1 << _rs);         // RS high (pull-up)
  #define LCD_RS_LO() DDRC |= 1 << _rs;            // RS low (pull-down)
  #define LCD_EN_LO() PORTD &= ~(1 << _en);        // EN low
  #define LCD_PREP_NIBBLE(b) (PORTD & ~(0xf << _dn)) | (b) << _dn | 1 << _en // Send data and enable high
  void begin(uint8_t x, uint8_t y){                // Send command
    DDRD |= 0xf << _dn | 1 << _en;                 // Make data, EN and RS pins outputs
    PORTC &= ~(1 << _rs);                          // Set RS low in case to support pull-down when DDRC is output
    delayMicroseconds(50000);                      // * At least 40ms after power rises above 2.7V before sending commands
    LCD_RS_LO();
    cmd(0x33);                                     // Ensures display is in 8-bit mode
    cmd(0x32);                                     // Puts display in 4-bit mode
    cmd(0x0e);                                     // Display and cursor on
    cmd(0x01);                                     // Clear display
    delay(3);                                      // Allow to execute on display [https://www.sparkfun.com/datasheets/LCD/HD44780.pdf, p.49, p58]
  }
  void nib(uint8_t b){                             // Send four bit nibble to display
    PORTD = LCD_PREP_NIBBLE(b);                    // Send data and enable high
    delayMicroseconds(4);
    LCD_EN_LO();
    delayMicroseconds(60);                         // Execution time  (was: 37)
  }
  void cmd(uint8_t b){ nib(b >> 4); nib(b & 0xf); }// Write command: send nibbles while RS low
  size_t write(uint8_t b){                         // Write data:    send nibbles while RS high
    uint8_t nibh = LCD_PREP_NIBBLE(b >>  4);       // Prepare high nibble data and enable high
    uint8_t nibl = LCD_PREP_NIBBLE(b & 0xf);       // Prepare low nibble data and enable high
    PORTD = nibh;                                  // Send high nibble data and enable high
    LCD_RS_HI();
    LCD_EN_LO();
    PORTD = nibl;                                  // Send low nibble data and enable high
    LCD_RS_LO();
    LCD_RS_HI();
    LCD_EN_LO();
    LCD_RS_LO();
    delayMicroseconds(41);                         // Execution time
    PORTD |= 0x02;                                 // To support serial-interface keep LCD_D5 high, so that DVM is not pulled-down via D
    return 1;
  }
  void setCursor(uint8_t x, uint8_t y){ cmd(0x80 | (x + y * 0x40)); }
  void cursor(){ cmd(0x0e); }
  void noCursor(){ cmd(0x0c); }
  void noDisplay(){ cmd(0x08); }
  void createChar(uint8_t l, uint8_t glyph[]){ cmd(0x40 | ((l & 0x7) << 3)); for(int i = 0; i != 8; i++) write(glyph[i]); }
  };
*/
/*
  #include <LiquidCrystal.h>
  class LCD_ : public LiquidCrystal {
  public: // QCXLiquidCrystal extends LiquidCrystal library for pull-up driven LCD_RS, as done on QCX. LCD_RS needs to be set to LOW in advance of calling any operation.
  //LCD_(uint8_t rs = LCD_RS, uint8_t en = LCD_EN, uint8_t d4 = LCD_D4, uint8_t d5, = LCD_D5 uint8_t d6 = LCD_D6, uint8_t d7 = LCD_D7) : LiquidCrystal(rs, en, d4, d5, d6, d7){ };
  LCD_() : LiquidCrystal(LCD_RS, LCD_EN, LCD_D4, LCD_D5, LCD_D6, LCD_D7){ };
  virtual size_t write(uint8_t value){ // overwrites LiquidCrystal::write() and re-implements LCD data writes
    pinMode(LCD_RS, INPUT);  // pull-up LCD_RS
    write4bits(value >> 4);
    write4bits(value);
    pinMode(LCD_RS, OUTPUT); // pull-down LCD_RS
    return 1;
  };
  void write4bits(uint8_t value){
    digitalWrite(LCD_D4, (value >> 0) & 0x01);
    digitalWrite(LCD_D5, (value >> 1) & 0x01);
    digitalWrite(LCD_D6, (value >> 2) & 0x01);
    digitalWrite(LCD_D7, (value >> 3) & 0x01);
    digitalWrite(LCD_EN, LOW);  // pulseEnable
    delayMicroseconds(1);
    digitalWrite(LCD_EN, HIGH);
    delayMicroseconds(1);    // enable pulse must be >450ns
    digitalWrite(LCD_EN, LOW);
    delayMicroseconds(100);   // commands need > 37us to settle
  };
  };
*/

/* // 6x8 technoblogy font
  const uint8_t font[]PROGMEM = {
   0x00, 0x00, 0x00, 0x00, 0x00, 0x00,
   0x00, 0x00, 0x5F, 0x00, 0x00, 0x00,
   0x00, 0x07, 0x00, 0x07, 0x00, 0x00,
   0x14, 0x7F, 0x14, 0x7F, 0x14, 0x00,
   0x24, 0x2A, 0x7F, 0x2A, 0x12, 0x00,
   0x23, 0x13, 0x08, 0x64, 0x62, 0x00,
   0x36, 0x49, 0x56, 0x20, 0x50, 0x00,
   0x00, 0x08, 0x07, 0x03, 0x00, 0x00,
   0x00, 0x1C, 0x22, 0x41, 0x00, 0x00,
   0x00, 0x41, 0x22, 0x1C, 0x00, 0x00,
   0x2A, 0x1C, 0x7F, 0x1C, 0x2A, 0x00,
   0x08, 0x08, 0x3E, 0x08, 0x08, 0x00,
   0x00, 0x80, 0x70, 0x30, 0x00, 0x00,
   0x08, 0x08, 0x08, 0x08, 0x08, 0x00,
   0x00, 0x00, 0x60, 0x60, 0x00, 0x00,
   0x20, 0x10, 0x08, 0x04, 0x02, 0x00,
   0x3E, 0x51, 0x49, 0x45, 0x3E, 0x00,
   0x00, 0x42, 0x7F, 0x40, 0x00, 0x00,
   0x72, 0x49, 0x49, 0x49, 0x46, 0x00,
   0x21, 0x41, 0x49, 0x4D, 0x33, 0x00,
   0x18, 0x14, 0x12, 0x7F, 0x10, 0x00,
   0x27, 0x45, 0x45, 0x45, 0x39, 0x00,
   0x3C, 0x4A, 0x49, 0x49, 0x31, 0x00,
   0x41, 0x21, 0x11, 0x09, 0x07, 0x00,
   0x36, 0x49, 0x49, 0x49, 0x36, 0x00,
   0x46, 0x49, 0x49, 0x29, 0x1E, 0x00,
   0x00, 0x00, 0x14, 0x00, 0x00, 0x00,
   0x00, 0x40, 0x34, 0x00, 0x00, 0x00,
   0x00, 0x08, 0x14, 0x22, 0x41, 0x00,
   0x14, 0x14, 0x14, 0x14, 0x14, 0x00,
   0x00, 0x41, 0x22, 0x14, 0x08, 0x00,
   0x02, 0x01, 0x59, 0x09, 0x06, 0x00,
   0x3E, 0x41, 0x5D, 0x59, 0x4E, 0x00,
   0x7C, 0x12, 0x11, 0x12, 0x7C, 0x00,
   0x7F, 0x49, 0x49, 0x49, 0x36, 0x00,
   0x3E, 0x41, 0x41, 0x41, 0x22, 0x00,
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
   0x41,0x7F,0x7F,0x49,0x49,0x7F,0x36,0x00, // 0x42
   0x1C,0x3E,0x63,0x41,0x41,0x63,0x22,0x00, // 0x43
   0x41,0x7F,0x7F,0x41,0x63,0x7F,0x1C,0x00, // 0x44
   0x41,0x7F,0x7F,0x49,0x5D,0x41,0x63,0x00, // 0x45
   0x41,0x7F,0x7F,0x49,0x1D,0x01,0x03,0x00, // 0x46
   0x1C,0x3E,0x63,0x41,0x51,0x73,0x72,0x00, // 0x47
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

  #define FONT_W 8
  #define FONT_H 2
  #define FONT_STRETCHV 1
  #define FONT_STRETCHH 0
*/
/*  显示单独翻转文字的时候，用下面这个格式
  SSD1306 are 0xA6 (normal) and 0xA7 (reverse).
  u8g.setFont(u8g_font_courB18r); u8g.drawStr( 12, 18, "GARAGE");
  u8g.drawStr( 23, 36, "DOOR"); u8g.drawStr( 8, 56, " OPEN");
  Wire.beginTransmission(OLED_I2C_ADDRESS); Wire.write(OLED_COMMAND);   //先发命令控制字，再发0XA7翻转，记得完成后再发0XA6翻转回来。
  Wire.write(0xA7); Wire.endTransmission(); } while( u8g.nextPage() );



*/





//#define INVERSE  1
static const uint8_t oled_init_sequence [] PROGMEM = {  // Initialization Sequence  https://cdn-shop.adafruit.com/datasheets/SSD1306.pdf
  //0xAE,       // Display OFF (sleep mode)
  0xD5, 0x80,   // 0x01--set display clock divide ratio/oscillator frequency   OK? (0x80 (or >=0x10) needed when multiplex ration set to 0x3F)
#ifdef CONDENSED
  0xA8, 0x3F,   // Set multiplex ratio(1 to 64)   128x64
#else
  0xA8, 0x1F,   // Set multiplex ratio(1 to 64)   128x32
#endif
  0xD3, 0x00,   // Set display offset. 00 = no offset
#ifndef OLED_SH1106  // for SSD1306 only:
  0x40,         // Set display start line address
  0x8D, 0x14,   // Set charge pump, internal VCC    //关闭电荷泵，减少干扰   (0x10 External, 0x14 Internal DC/DC)
  0x20, 0x02,   // Set Memory Addressing; 0=Horizontal Mode; 1=Vertical Mode; 2=Page Mode
  0xA4,     // Output RAM to Display  (display all on resume)   0xA4=Output follows RAM content; 0xA5,Output ignores RAM content
#endif //!OLED_SH1106
  0xA0,         // Set Segment Re-map. A0=column 0 mapped to SEG0; A1=column 127 mapped to SEG0. Flip Horizontally  默认A1,翻转A0
  0xC0,         // Set COM Output Scan Direction.  Flip Veritically.  默认C8，翻转C0
#ifdef CONDENSED
  0xDA, 0x12,   // Set com pins hardware configuration  128x64
#else
  0xDA, 0x02,   // Set com pins hardware configuration  128x32
#endif
  0x81, 0x80,   // Set contrast control register
  0xDB, 0x40,   // Set vcomh 0x20 = 0.77xVcc
  0xD9, 0xF1,   // 0xF1=brighter //0x22 Set pre-charge period
  0xB0 | 0x0,   // Set page address, 0-7
#ifdef OLED_SH1106
  0xAD, 0x8B,   // SH1106 Set pump mode: pump ON
  0x30 | 0x2,   // SH1106 Pump voltage 8.0V
#endif //OLED_SH1106
#ifdef INVERSE
  0xA7,         // Set display mode: Inverse
#else
  0xA6,         // Set display mode: Normal
#endif
  0x00,       // Set low nibble of column address
  //0x10,       // Set high nibble of column address
  0xAF,         // Display ON
};

class OLEDDevice: public Print {  // https://www.buydisplay.com/download/manual/ER-OLED0.91-3_Series_Datasheet.pdf
  public:
#define OLED_ADDR    0x3C  // Slave address
#define OLED_PAGES   4
#define OLED_COMMAND 0x00
#define OLED_DATA    0x40
    uint8_t oledX = 0, oledY = 0;
    uint8_t renderingFrame = 0xB0;
    bool wrap = false;
    void cmd(uint8_t b) {
      Wire.beginTransmission(OLED_ADDR); Wire.write(OLED_COMMAND);
      Wire.write(b);
      Wire.endTransmission();
    }
    void begin(uint8_t cols, uint8_t rows, uint8_t charsize = 0) {
      Wire.begin();
      Wire.beginTransmission(OLED_ADDR); Wire.write(OLED_COMMAND);
      for (uint8_t i = 0; i < sizeof(oled_init_sequence); i++) {
        Wire.write(pgm_read_byte(&oled_init_sequence[i]));
      }
      Wire.endTransmission();
      delayMicroseconds(100);
#ifdef CONDENSED
      for (uint8_t y = 0; y != rows; y++) for (uint8_t x = 0; x != cols; x++) {
          setCursor(x, y);  // clear
          write(' ');
        }
#endif
    }
    bool curs = false;
    void noCursor() {
      curs = false;
    }
    void cursor() {
      curs = true;
    }
    void noDisplay() {
      cmd(0xAE);
    }
    void createChar(uint8_t l, uint8_t glyph[]) {}

    void _setCursor(uint8_t x, uint8_t y) {
      oledX = x; oledY = y;
      Wire.beginTransmission(OLED_ADDR); Wire.write(OLED_COMMAND);
      Wire.write(renderingFrame | (oledY & 0x07));
      uint8_t _oledX = oledX;
#ifdef OLED_SH1106
      _oledX += 2; // SH1106 is a 132x64 controller.  Use middle 128 columns.
#endif
      Wire.write(0x10 | ((_oledX & 0xf0) >> 4));
      Wire.write(_oledX & 0x0f);
      Wire.endTransmission();
    }
    void drawCursor(bool en) {
      //_setCursor(oledX, oledY + (FONT_W/(FONT_STRETCHH+1)));
      Wire.beginTransmission(OLED_ADDR); Wire.write(OLED_DATA);
      Wire.write((en) ? 0xf0 : 0x00);  // horizontal line
      Wire.endTransmission();
    }
    void setCursor(uint8_t x, uint8_t y) {
      if (curs) {
        drawCursor(false);
      } _setCursor(x * FONT_W, y * FONT_H); if (curs) {
        drawCursor(true);
        _setCursor(oledX, oledY);
      }
    }

    void newLine() {
      oledY += FONT_H;
      if (oledY > OLED_PAGES - FONT_H) {
        oledY = OLED_PAGES - FONT_H;
      }
      _setCursor(0, oledY);
    }

    size_t write(byte c) {
      if ((c == '\n') || (oledX > ((uint8_t)128 - FONT_W)) ) {
        if (wrap)  newLine();
        return 1;
      }
      //if(oledY > OLED_PAGES - FONT_H) return; //needed?
      c = ((c < 9) ? (c + '~') : c) - ' ';

      uint16_t offset = ((uint16_t)c) * FONT_W / (FONT_STRETCHH + 1) * FONT_H;
      uint8_t line = FONT_H;
      do
      {
        if (FONT_STRETCHV) offset = ((uint16_t)c) * FONT_W / (FONT_STRETCHH + 1) * FONT_H / (2 * FONT_STRETCHV);
        Wire.beginTransmission(OLED_ADDR); Wire.write(OLED_DATA);
        for (uint8_t i = 0; i < (FONT_W / (FONT_STRETCHH + 1)); i++) {
          uint8_t b = pgm_read_byte(&(font[offset++]));
          if (FONT_STRETCHV) {
            uint8_t b2 = 0;
            if (line > 1) for (int i = 0; i != 4; i++) b2 |=/* ! */(b & (1 << i)) ? (1 << (i * 2)) | (1 << ((i * 2) + 1)) : 0x00;
            else         for (int i = 0; i != 4; i++) b2 |=/* ! */(b & (1 << (i + 4))) ? (1 << (i * 2)) | (1 << ((i * 2) + 1)) : 0x00;
            Wire.write(b2);
            if (FONT_STRETCHH) Wire.write(b2);
          } else {
            Wire.write(b);
            if (FONT_STRETCHH) Wire.write(b);
          }
        }
        Wire.endTransmission();
        if (FONT_H == 1) {
          oledX += FONT_W;
        }
        else {
          if (line > 1) {
            _setCursor(oledX, oledY + 1);
          }
          else {
            _setCursor(oledX + FONT_W, oledY - (FONT_H - 1));
          }
        }
      }
      while (--line);
      return 1;
    }

    void bitmap(uint8_t x0, uint8_t y0, uint8_t x1, uint8_t y1, const uint8_t bitmap[]) {
      uint16_t j = 0;
      for (uint8_t y = y0; y < y1; y++) {
        _setCursor(x0, y);
        Wire.beginTransmission(OLED_ADDR); Wire.write(OLED_DATA);
        for (uint8_t x = x0; x < x1; x++) {
          Wire.write(pgm_read_byte(&bitmap[j++]));
        }
        Wire.endTransmission();
      }
      setCursor(0, 0);
    }
};

template<class parent>class Display : public parent {  // This class spoofs display contents and cursor state
  public:
#ifdef CAT_EXT
    uint8_t x, y;
    bool curs;
    char text[2 * 16 + 1];
    Display() : parent() {
      clear();
    };
    size_t write(uint8_t b) {
      if ((x < 16) && (y < 2)) {
        text[y * 16 + x] = ((b < 9) ? "> :*#AB"[b - 1] /*(b + 0x80 - 1)*/ /*(uint8_t[]){ 0xAF, 0x20, 0xB0, 0xB1, 0xB2, 0xA6, 0xE1, 0x20 }[b-1]*/ : b);
        x++;
      } return parent::write(b);
    }
    void setCursor(uint8_t _x, uint8_t _y) {
      x = _x;
      y = _y;
      parent::setCursor(_x, _y);
    }
    void cursor() {
      curs = true;
      parent::cursor();
    }
    void noCursor() {
      curs = false;
      parent::noCursor();
    }
    void clear() {
      for (uint8_t i = 0; i != 2 * 16; i++) text[i] = ' ' ;
      text[2 * 16] = '\0';
      x = 0;
      y = 0;
    }
#endif //CAT_EXT
};
//#define BLIND 1             // uSDX in head-less operation
#ifdef BLIND
class Blind : public Print {  // This class is a dummy LCD replacement
  public:
    size_t write(uint8_t b) {}
    void setCursor(uint8_t _x, uint8_t _y) {}
    void cursor() {}
    void noCursor() {}
    void begin(uint8_t x = 0, uint8_t y = 0) {}
    void noDisplay() {}
    void createChar(uint8_t l, uint8_t glyph[]) {}
};
Display<Blind> lcd;
#else
#ifdef OLED
Display<OLEDDevice> lcd;
#else
Display<LCD> lcd;     // highly-optimized LCD driver, OK for QCX supplied displays
//LCD_ lcd;  // slower LCD, suitable for non-QCX supplied displays
//#include <LiquidCrystal.h>
//LiquidCrystal lcd(LCD_RS, LCD_EN, LCD_D4, LCD_D5, LCD_D6, LCD_D7);
#endif
#endif

volatile int8_t encoder_val = 0;
volatile int8_t encoder_step = 0;
static uint8_t last_state;
ISR(PCINT2_vect) { // Interrupt on rotary encoder turn
  //noInterrupts();
  //PCMSK2 &= ~((1 << PCINT22) | (1 << PCINT23));  // mask ROT_A, ROT_B interrupts
  switch (last_state = (last_state << 4) | (_digitalRead(ROT_B) << 1) | _digitalRead(ROT_A)) { //transition  (see: https://www.allaboutcircuits.com/projects/how-to-use-a-rotary-encoder-in-a-mcu-based-project/  )
#define ENCODER_ENHANCED_RESOLUTION  1     //编码器速度调整
#ifdef ENCODER_ENHANCED_RESOLUTION // Option: enhance encoder from 24 to 96 steps/revolution, see: appendix 1, https://www.sdr-kits.net/documents/PA0KLT_Manual.pdf
    //    case 0x31: case 0x10: case 0x02: case 0x23: encoder_val++; break;   //4倍速度
    //    case 0x32: case 0x20: case 0x01: case 0x13: encoder_val--; break;
    case 0x31:  case 0x23:  encoder_val++; break; //2倍速度
    case 0x32:  case 0x13:  encoder_val--; break;
#else
    //    case 0x31: case 0x10: case 0x02: case 0x23: if(encoder_step < 0) encoder_step = 0; encoder_step++; if(encoder_step >  3){ encoder_step = 0; encoder_val++; } break;  // encoder processing for additional immunity to weared-out rotary encoders
    //    case 0x32: case 0x20: case 0x01: case 0x13: if(encoder_step > 0) encoder_step = 0; encoder_step--; if(encoder_step < -3){ encoder_step = 0; encoder_val--; } break;
    case 0x23:  encoder_val++; break;
    case 0x32:  encoder_val--; break;
#endif
  }
  //PCMSK2 |= (1 << PCINT22) | (1 << PCINT23);  // allow ROT_A, ROT_B interrupts
  //interrupts();
}
void encoder_setup()
{
  pinMode(ROT_A, INPUT_PULLUP);
  pinMode(ROT_B, INPUT_PULLUP);
  PCMSK2 |= (1 << PCINT22) | (1 << PCINT23); // interrupt-enable for ROT_A, ROT_B pin changes; see https://github.com/EnviroDIY/Arduino-SDI-12/wiki/2b.-Overview-of-Interrupts
  PCICR |= (1 << PCIE2);
  last_state = (_digitalRead(ROT_B) << 1) | _digitalRead(ROT_A);
  interrupts();
}
/*
  class Encoder {
  public:
  volatile int8_t val = 0;
  volatile int8_t step = 0;
  uint8_t last_state;
  Encoder(){
    pinMode(ROT_A, INPUT_PULLUP);
    pinMode(ROT_B, INPUT_PULLUP);
    PCMSK2 |= (1 << PCINT22) | (1 << PCINT23); // interrupt-enable for ROT_A, ROT_B pin changes; see https://github.com/EnviroDIY/Arduino-SDI-12/wiki/2b.-Overview-of-Interrupts
    PCICR |= (1 << PCIE2);
    last_state = (_digitalRead(ROT_B) << 1) | _digitalRead(ROT_A);
    sei();
  }
  void event(){
    switch(last_state = (last_state << 4) | (_digitalRead(ROT_B) << 1) | _digitalRead(ROT_A)){ //transition  (see: https://www.allaboutcircuits.com/projects/how-to-use-a-rotary-encoder-in-a-mcu-based-project/  )
      case 0x31: case 0x10: case 0x02: case 0x23: if(step < 0) step = 0; step++; if(step >  3){ step = 0; val++; } break;
      case 0x32: case 0x20: case 0x01: case 0x13: if(step > 0) step = 0; step--; if(step < -3){ step = 0; val--; } break;
    }
  }
  };
  Encoder enc;
  ISR(PCINT2_vect){  // Interrupt on rotary encoder turn
  enc.event();
  }*/

// I2C communication starts with a START condition, multiple single byte-transfers (MSB first) followed by an ACK/NACK and stops with a STOP condition;
// during data-transfer SDA may only change when SCL is LOW, during a START/STOP condition SCL is HIGH and SDA goes DOWN for a START and UP for a STOP.
// https://www.ti.com/lit/an/slva704/slva704.pdf
class I2C {
  public:
#if(F_MCU > 20900000)
#define I2C_DELAY   6
#else
#define I2C_DELAY   4    // Determines I2C Speed (2=939kb/s (too fast!!); 3=822kb/s; 4=731kb/s; 5=658kb/s; 6=598kb/s). Increase this value when you get I2C tx errors (E05); decrease this value when you get a CPU overload (E01). An increment eats ~3.5% CPU load; minimum value is 3 on my QCX, resulting in 84.5% CPU load
#endif
#define I2C_DDR DDRC     // Pins for the I2C bit banging
#define I2C_PIN PINC
#define I2C_PORT PORTC
#define I2C_SDA (1 << 4) // PC4
#define I2C_SCL (1 << 5) // PC5
#define DELAY(n) for(uint8_t i = 0; i != n; i++) asm("nop");
#define I2C_SDA_GET() I2C_PIN & I2C_SDA
#define I2C_SCL_GET() I2C_PIN & I2C_SCL
#define I2C_SDA_HI() I2C_DDR &= ~I2C_SDA;
#define I2C_SDA_LO() I2C_DDR |=  I2C_SDA;
#define I2C_SCL_HI() I2C_DDR &= ~I2C_SCL; DELAY(I2C_DELAY);
#define I2C_SCL_LO() I2C_DDR |=  I2C_SCL; DELAY(I2C_DELAY);

    I2C() {
      I2C_PORT &= ~( I2C_SDA | I2C_SCL );
      I2C_SCL_HI();
      I2C_SDA_HI();
#ifndef RS_HIGH_ON_IDLE
      suspend();
#endif
    }
    ~I2C() {
      I2C_PORT &= ~( I2C_SDA | I2C_SCL );
      I2C_DDR &= ~( I2C_SDA | I2C_SCL );
    }
    inline void start() {
#ifdef RS_HIGH_ON_IDLE
      I2C_SDA_LO();
#else
      resume();  //prepare for I2C
#endif
      I2C_SCL_LO();
      I2C_SDA_HI();
    }
    inline void stop() {
      I2C_SDA_LO();   // ensure SDA is LO so STOP-condition can be initiated by pulling SCL HI (in case of ACK it SDA was already LO, but for a delayed ACK or NACK it is not!)
      I2C_SCL_HI();
      I2C_SDA_HI();
      I2C_DDR &= ~(I2C_SDA | I2C_SCL); // prepare for a start: pull-up both SDA, SCL
#ifndef RS_HIGH_ON_IDLE
      suspend();
#endif
    }
#define SendBit(data, mask) \
  if(data & mask){ \
    I2C_SDA_HI();  \
  } else {         \
    I2C_SDA_LO();  \
  }                \
  I2C_SCL_HI();    \
  I2C_SCL_LO();
    /*#define SendByte(data) \
      SendBit(data, 1 << 7) \
      SendBit(data, 1 << 6) \
      SendBit(data, 1 << 5) \
      SendBit(data, 1 << 4) \
      SendBit(data, 1 << 3) \
      SendBit(data, 1 << 2) \
      SendBit(data, 1 << 1) \
      SendBit(data, 1 << 0) \
      I2C_SDA_HI();  // recv ACK \
      DELAY(I2C_DELAY);     \
      I2C_SCL_HI();         \
      I2C_SCL_LO();*/
    inline void SendByte(uint8_t data) {
      SendBit(data, 1 << 7);
      SendBit(data, 1 << 6);
      SendBit(data, 1 << 5);
      SendBit(data, 1 << 4);
      SendBit(data, 1 << 3);
      SendBit(data, 1 << 2);
      SendBit(data, 1 << 1);
      SendBit(data, 1 << 0);
      I2C_SDA_HI();  // recv ACK
      DELAY(I2C_DELAY);
      I2C_SCL_HI();
      I2C_SCL_LO();
    }
    inline uint8_t RecvBit(uint8_t mask) {
      I2C_SCL_HI();
      uint16_t i = 60000;
      for (; !(I2C_SCL_GET()) && i; i--); // wait util slave release SCL to HIGH (meaning data valid), or timeout at 3ms
      //if(!i){ lcd.setCursor(0, 1); lcd.print(F("E07 I2C timeout")); }
      uint8_t data = I2C_SDA_GET();
      I2C_SCL_LO();
      return (data) ? mask : 0;
    }
    inline uint8_t RecvByte(uint8_t last) {
      uint8_t data = 0;
      data |= RecvBit(1 << 7);
      data |= RecvBit(1 << 6);
      data |= RecvBit(1 << 5);
      data |= RecvBit(1 << 4);
      data |= RecvBit(1 << 3);
      data |= RecvBit(1 << 2);
      data |= RecvBit(1 << 1);
      data |= RecvBit(1 << 0);
      if (last) {
        I2C_SDA_HI();  // NACK
      } else {
        I2C_SDA_LO();  // ACK
      }
      DELAY(I2C_DELAY);
      I2C_SCL_HI();
      I2C_SDA_HI();    // restore SDA for read
      I2C_SCL_LO();
      return data;
    }
    inline void resume() {
#ifdef LCD_RS_PORTIO
      I2C_PORT &= ~I2C_SDA; // pin sharing SDA/LCD_RS mitigation
#endif
    }
    inline void suspend() {
      I2C_SDA_LO();         // pin sharing SDA/LCD_RS: pull-down LCD_RS; QCXLiquidCrystal require this for any operation
    }

    void begin() {};
    void beginTransmission(uint8_t addr) {
      start();
      SendByte(addr << 1);
    };
    bool write(uint8_t byte) {
      SendByte(byte);
      return 1;
    };
    uint8_t endTransmission() {
      stop();
      return 0;
    };
};

//#define log2(n) (log(n) / log(2))
uint8_t log2(uint16_t x) {
  uint8_t y = 0;
  for (; x >>= 1;) y++;
  return y;
}

// /*
I2C i2c;
class SI5351 {
  public:
    volatile int32_t _fout;
    volatile uint8_t _div;  // note: uint8_t asserts fout > 3.5MHz with R_DIV=1
    volatile uint16_t _msa128min512;
    volatile uint32_t _msb128;
    //volatile uint32_t _mod;
    volatile uint8_t pll_regs[8];

#define BB0(x) ((uint8_t)(x))           // Bash byte x of int32_t
#define BB1(x) ((uint8_t)((x)>>8))
#define BB2(x) ((uint8_t)((x)>>16))

#define FAST __attribute__((optimize("Ofast")))

    volatile uint32_t fxtal = F_XTAL;

#define NEW_TX 1
#ifdef NEW_TX
    inline void FAST freq_calc_fast(int16_t df)  // note: relies on cached variables: _msb128, _msa128min512, _div, _fout, fxtal
    {
#define _MSC  0x10000
      uint32_t msb128 = _msb128 + ((int64_t)(_div * (int32_t)df) * _MSC * 128) / fxtal;

      uint16_t msp1 = _msa128min512 + msb128 / _MSC; // = 128 * _msa + msb128 / _MSC - 512;
      uint16_t msp2 = msb128; // = msb128 % _MSC;  assuming MSC is covering exact uint16_t so the mod operation can dissapear (and the upper BB2 byte) // = msb128 - msb128/_MSC * _MSC;

      //pll_regs[0] = BB1(msc);  // 3 regs are constant
      //pll_regs[1] = BB0(msc);
      //pll_regs[2] = BB2(msp1);
      //pll_regs[3] = BB1(msp1);
      pll_regs[4] = BB0(msp1);
      pll_regs[5] = ((_MSC & 0xF0000) >> (16 - 4))/*|BB2(msp2)*/; // top nibble MUST be same as top nibble of _MSC !  assuming that BB2(msp2) is always 0 -> so reg is constant
      pll_regs[6] = BB1(msp2);
      pll_regs[7] = BB0(msp2);
    }

    inline void SendPLLRegisterBulk() {
      i2c.start();
      i2c.SendByte(SI5351_ADDR << 1);
      i2c.SendByte(26 + 0 * 8 + 4); // Write to PLLA
      //i2c.SendByte(26+1*8 + 4);  // Write to PLLB
      i2c.SendByte(pll_regs[4]);
      i2c.SendByte(pll_regs[5]);
      i2c.SendByte(pll_regs[6]);
      i2c.SendByte(pll_regs[7]);
      i2c.stop();
    }
#else  // !NEW_TX
    inline void FAST freq_calc_fast(int16_t df)  // note: relies on cached variables: _msb128, _msa128min512, _div, _fout, fxtal
    {
#define _MSC  0x80000  //0x80000: 98% CPU load   0xFFFFF: 114% CPU load
      uint32_t msb128 = _msb128 + ((int64_t)(_div * (int32_t)df) * _MSC * 128) / fxtal;
      //uint32_t msb128 = ((int64_t)(_div * (int32_t)df + _mod) * _MSC * 128) / fxtal; // @pre: 14<=_div<=144, |df|<=5000, _mod<=1800e3 (for fout<30M), _MSC=524288

      //#define _MSC  (F_XTAL/128)   // MSC exact multiple of F_XTAL (and maximized to fit in max. span 1048575)
      //uint32_t msb128 = (_div * (int32_t)df + _mod);

      //#define _MSC  0xFFFFF  // Old algorithm 114% CPU load, shortcut for a fixed fxtal=27e6
      //register uint32_t xmsb = (_div * (_fout + (int32_t)df)) % fxtal;  // xmsb = msb * fxtal/(128 * _MSC);
      //uint32_t msb128 = xmsb * 5*(32/32) - (xmsb/32);  // msb128 = xmsb * 159/32, where 159/32 = 128 * 0xFFFFF / fxtal; fxtal=27e6

      //#define _MSC  (F_XTAL/128)  // 114% CPU load  perfect alignment
      //uint32_t msb128 = (_div * (_fout + (int32_t)df)) % fxtal;

      uint32_t msp1 = _msa128min512 + msb128 / _MSC;  // = 128 * _msa + msb128 / _MSC - 512;
      uint32_t msp2 = msb128 % _MSC;  // = msb128 - msb128/_MSC * _MSC;
      //uint32_t msp1 = _msa128min512;  // = 128 * _msa + msb128 / _MSC - 512;  assuming msb128 < _MSC, so that msp1 is constant
      //uint32_t msp2 = msb128;  // = msb128 - msb128/_MSC * _MSC, assuming msb128 < _MSC

      //pll_regs[0] = BB1(msc);  // 3 regs are constant
      //pll_regs[1] = BB0(msc);
      //pll_regs[2] = BB2(msp1);
      pll_regs[3] = BB1(msp1);
      pll_regs[4] = BB0(msp1);
      pll_regs[5] = ((_MSC & 0xF0000) >> (16 - 4)) | BB2(msp2); // top nibble MUST be same as top nibble of _MSC !
      pll_regs[6] = BB1(msp2);
      pll_regs[7] = BB0(msp2);
    }

    inline void SendPLLRegisterBulk() {
      i2c.start();
      i2c.SendByte(SI5351_ADDR << 1);
      i2c.SendByte(26 + 0 * 8 + 3); // Write to PLLA
      //i2c.SendByte(26+1*8 + 3);  // Write to PLLB
      i2c.SendByte(pll_regs[3]);
      i2c.SendByte(pll_regs[4]);
      i2c.SendByte(pll_regs[5]);
      i2c.SendByte(pll_regs[6]);
      i2c.SendByte(pll_regs[7]);
      i2c.stop();
    }
#endif // !NEW_TX

    void SendRegister(uint8_t reg, uint8_t* data, uint8_t n) {
      i2c.start();
      i2c.SendByte(SI5351_ADDR << 1);
      i2c.SendByte(reg);
      while (n--) i2c.SendByte(*data++);
      i2c.stop();
    }
    void SendRegister(uint8_t reg, uint8_t val) {
      SendRegister(reg, &val, 1);
    }
    int16_t iqmsa; // to detect a need for a PLL reset
    ///*
    enum ms_t { PLLA = 0, PLLB = 1, MSNA = -2, MSNB = -1, MS0 = 0, MS1 = 1, MS2 = 2, MS3 = 3, MS4 = 4, MS5 = 5 };

    void ms(int8_t n, uint32_t div_nom, uint32_t div_denom, uint8_t pll = PLLA, uint8_t _int = 0, uint16_t phase = 0, uint8_t rdiv = 0) {
      uint16_t msa; uint32_t msb, msc, msp1, msp2, msp3;
      msa = div_nom / div_denom;     // integer part: msa must be in range 15..90 for PLL, 8+1/1048575..900 for MS
      if (msa == 4) _int = 1; // To satisfy the MSx_INT=1 requirement of AN619, section 4.1.3 which basically says that for MS divider a value of 4 and integer mode must be used
      msb = (_int) ? 0 : (((uint64_t)(div_nom % div_denom) * _MSC) / div_denom); // fractional part
      msc = (_int) ? 1 : _MSC;
      //lcd.setCursor(0, 0); lcd.print(n); lcd.print(":"); lcd.print(msa); lcd.print(" "); lcd.print(msb); lcd.print(" "); lcd.print(msc); lcd.print(F("    ")); delay(500);
      msp1 = 128 * msa + 128 * msb / msc - 512;
      msp2 = 128 * msb - 128 * msb / msc * msc;
      msp3 = msc;
      uint8_t ms_reg2 = BB2(msp1) | (rdiv << 4) | ((msa == 4) * 0x0C);
      uint8_t ms_regs[8] = { BB1(msp3), BB0(msp3), ms_reg2, BB1(msp1), BB0(msp1), BB2(((msp3 & 0x0F0000) << 4) | msp2), BB1(msp2), BB0(msp2) };

      SendRegister(n * 8 + 42, ms_regs, 8); // Write to MSx
      if (n < 0) {
        SendRegister(n + 16 + 8, 0x80 | (0x40 * _int)); // MSNx PLLn: 0x40=FBA_INT; 0x80=CLKn_PDN
      } else {
        SendRegister(n + 16, ((pll) * 0x20) | 0x0C | 0 | (0x40 * _int)); // MSx CLKn: 0x0C=PLLA,0x2C=PLLB local msynth; 0=2mA; 0x40=MSx_INT; 0x80=CLKx_PDN    //修正使用MS5351输出增益过高引起相邻输出不同相位导致输出干扰，具体表现为ssb解调问题
        //      SendRegister(n+16, ((pll)*0x20)|0x0C|3|(0x40*_int));  // MSx CLKn: 0x0C=PLLA,0x2C=PLLB local msynth; 3=8mA; 0x40=MSx_INT; 0x80=CLKx_PDN
        SendRegister(n + 165, (!_int) * phase * msa / 90);    // when using: make sure to configure MS in fractional-mode, perform reset afterwards
      }
    }

    void phase(int8_t n, uint32_t div_nom, uint32_t div_denom, uint16_t phase) {
      SendRegister(n + 165, phase * (div_nom / div_denom) / 90);  // when using: make sure to configure MS in fractional-mode!, perform reset afterwards
    }

    void reset() {
      SendRegister(177, 0xA0);  // 0x20 reset PLLA; 0x80 reset PLLB
    }

    void oe(uint8_t mask) {
      SendRegister(3, ~mask);  // output-enable mask: CLK2=4; CLK1=2; CLK0=1
    }

    void freq(int32_t fout, uint16_t i, uint16_t q) { // Set a CLK0,1,2 to fout Hz with phase i, q (on PLLA)
      uint8_t rdiv = 0; // CLK pin sees fout/(2^rdiv)
      if (fout > 300000000) {
        i /= 3;  // for higher freqs, use 3rd harmonic
        q /= 3;
        fout /= 3;
      }
      if (fout < 500000) {
        rdiv = 7;  // Divide by 128 for fout 4..500kHz
        fout *= 128;
      }
      uint16_t d; if (fout < 30000000) d = (16 * fxtal) / fout; else d = (32 * fxtal) / fout; // Integer part  .. maybe 44?
      if (fout < 3500000) d = (7 * fxtal) / fout; // PLL at 189MHz to cover 160m (freq>1.48MHz) when using 27MHz crystal
      if (fout > 140000000) d = 4; // for f=140..300MHz; AN619; 4.1.3, this implies integer mode
      if (d % 2) d++; // even numbers preferred for divider (AN619 p.4 and p.6)
      if ( (d * (fout - 5000) / fxtal) != (d * (fout + 5000) / fxtal) ) d += 2; // Test if multiplier remains same for freq deviation +/- 5kHz, if not use different divider to make same
      uint32_t fvcoa = d * fout;  // Variable PLLA VCO frequency at integer multiple of fout at around 27MHz*16 = 432MHz
      // si5351 spectral purity considerations: https://groups.io/g/QRPLabs/message/42662

      ms(MSNA, fvcoa, fxtal);                   // PLLA in fractional mode
      //ms(MSNB, fvcoa, fxtal);
      ms(MS0,  fvcoa, fout, PLLA, 0, i, rdiv);  // Multisynth stage with integer divider but in frac mode due to phase setting
      ms(MS1,  fvcoa, fout, PLLA, 0, q, rdiv);
#ifdef F_CLK2
      freqb(F_CLK2);
#else
      ms(MS2,  fvcoa, fout, PLLA, 0, 0, rdiv);
#endif
      if (iqmsa != (((int8_t)i - (int8_t)q) * ((int16_t)(fvcoa / fout)) / 90)) {
        iqmsa = ((int8_t)i - (int8_t)q) * ((int16_t)(fvcoa / fout)) / 90;
        reset();
      }
      oe(0b00000011);  // output enable CLK0, CLK1

#ifdef x
      ms(MSNA, fvcoa, fxtal);
      ms(MSNB, fvcoa, fxtal);
#define F_DEV 4
      ms(MS0,  fvcoa, (fout + F_DEV), PLLA, 0, 0, rdiv);
      ms(MS1,  fvcoa, (fout + F_DEV), PLLA, 0, 0, rdiv);
      ms(MS2,  fvcoa, fout, PLLA, 0, 0, rdiv);
      reset();
      ms(MS0,  fvcoa, fout, PLLA, 0, 0, rdiv);
      delayMicroseconds(F_MCU / 16000000 * 1000000UL / F_DEV); // Td = 1/(4 * Fdev) phase-shift   https://tj-lab.org/2020/08/27/si5351%e5%8d%98%e4%bd%93%e3%81%a73mhz%e4%bb%a5%e4%b8%8b%e3%81%ae%e7%9b%b4%e4%ba%a4%e4%bf%a1%e5%8f%b7%e3%82%92%e5%87%ba%e5%8a%9b%e3%81%9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
      ms(MS1,  fvcoa, fout, PLLA, 0, 0, rdiv);
      oe(0b00000011);  // output enable CLK0, CLK1
#endif
      _fout = fout;  // cache
      _div = d;
      _msa128min512 = fvcoa / fxtal * 128 - 512;
      _msb128 = ((uint64_t)(fvcoa % fxtal) * _MSC * 128) / fxtal;
      //_mod = fvcoa % fxtal;
    }

    void freqb(uint32_t fout) { // Set a CLK2 to fout Hz (on PLLB)
      uint16_t d = (16 * fxtal) / fout;
      if (d % 2) d++; // even numbers preferred for divider (AN619 p.4 and p.6)
      uint32_t fvcoa = d * fout;  // Variable PLLA VCO frequency at integer multiple of fout at around 27MHz*16 = 432MHz

      ms(MSNB, fvcoa, fxtal);
      ms(MS2,  fvcoa, fout, PLLB, 0, 0, 0);
    }

    //*/
    /*
      void freq(uint32_t fout, uint16_t i, uint16_t q){  // Set a CLK0,1 to fout Hz with phase i, q
          uint16_t msa; uint32_t msb, msc, msp1, msp2, msp3;
          uint8_t rdiv = 0;             // CLK pin sees fout/(2^rdiv)
          if(fout > 300000000){ i/=3; q/=3; fout/=3; }  // for higher freqs, use 3rd harmonic
          if(fout < 500000){ rdiv = 7; fout *= 128; } // Divide by 128 for fout 4..500kHz

          uint16_t d = (16 * fxtal) / fout;  // Integer part
          //if(fout > 7000000) d = (33 * fxtal) / fout;
          if(fout < 3500000) d = (7 * fxtal) / fout;  // PLL at 189MHz to cover 160m (freq>1.48MHz) when using 27MHz crystal

          if( (d * (fout - 5000) / fxtal) != (d * (fout + 5000) / fxtal) ) d++; // Test if multiplier remains same for freq deviation +/- 5kHz, if not use different divider to make same
          if(d % 2) d++;  // even numbers preferred for divider (AN619 p.4 and p.6)
          bool divby4 = 0; if(fout > 140000000){ d = 4; divby4 = 1; } // for f=140..300MHz; AN619; 4.1.3
          uint32_t fvcoa = d * fout;  // Variable PLLA VCO frequency at integer multiple of fout at around 27MHz*16 = 432MHz
          msa = fvcoa / fxtal;     // Integer part of vco/fxtal. msa must be in range 15..90
          msb = ((uint64_t)(fvcoa % fxtal)*_MSC) / fxtal; // fractional part
          msc = _MSC;

          msp1 = 128*msa + 128*msb/msc - 512;
          msp2 = 128*msb - 128*msb/msc * msc;
          msp3 = msc;
          uint8_t pll_regs[8] = { BB1(msp3), BB0(msp3), BB2(msp1), BB1(msp1), BB0(msp1), BB2(((msp3 & 0x0F0000)<<4) | msp2), BB1(msp2), BB0(msp2) };
          SendRegister(26+0*8, pll_regs, 8); // Write to PLLA
          SendRegister(26+1*8, pll_regs, 8); // Write to PLLB
          SendRegister(16+6, 0x80); // PLLA in fractional mode; 0x40=FBA_INT; 0x80=CLK6_PDN
          SendRegister(16+7, 0x80); // PLLB in fractional mode; 0x40=FBB_INT; 0x80=CLK7_PDN

          msa = fvcoa / fout;     // Integer part of vco/fout. msa must be in range 6..127 (support for integer and initial phase offset)
          //lcd.setCursor(0, 0); lcd.print(fvcoa/fxtal); lcd.print(" "); lcd.print(msb); lcd.print(" "); lcd.print(msa); lcd.print(F("     "));
          msp1 = (divby4) ? 0 : (128*msa - 512);     // msp1 and msp2=0, msp3=1, integer division
          msp2 = 0;
          msp3 = 1;
          uint8_t ms_regs[8] = { BB1(msp3), BB0(msp3), BB2(msp1) | (rdiv<<4) | (divby4*0x0C), BB1(msp1), BB0(msp1), BB2(((msp3 & 0x0F0000)<<4) | msp2), BB1(msp2), BB0(msp2) };
          SendRegister(42+0*8, ms_regs, 8); // Write to MS0
          SendRegister(42+1*8, ms_regs, 8); // Write to MS1
          SendRegister(42+2*8, ms_regs, 8); // Write to MS2
          SendRegister(16+0, 0x0C|3|(0x40*divby4));  // CLK0: 0x0C=PLLA local msynth; 3=8mA; 0x40=MS0_INT; 0x80=CLK0_PDN
          SendRegister(16+1, 0x0C|3|(0x40*divby4));  // CLK1: 0x0C=PLLA local msynth; 3=8mA; 0x40=MS1_INT; 0x80=CLK1_PDN
          SendRegister(16+2, 0x2C|3|(0x40*divby4));  // CLK2: 0x2C=PLLB local msynth; 3=8mA; 0x40=MS2_INT; 0x80=CLK2_PDN
          SendRegister(165, i * msa / 90);  // CLK0: I-phase (on change -> Reset PLL)
          SendRegister(166, q * msa / 90);  // CLK1: Q-phase (on change -> Reset PLL)
          if(iqmsa != ((i-q)*msa/90)){ iqmsa = (i-q)*msa/90; SendRegister(177, 0xA0); } // 0x20 reset PLLA; 0x80 reset PLLB
          SendRegister(3, 0b11111100);      // Enable/disable clock

          _fout = fout;  // cache
          _div = d;
          _msa128min512 = fvcoa / fxtal * 128 - 512;
          _msb128=((uint64_t)(fvcoa % fxtal)*_MSC*128) / fxtal;
      }
    */
    uint8_t RecvRegister(uint8_t reg) {
      i2c.start();  // Data write to set the register address
      i2c.SendByte(SI5351_ADDR << 1);
      i2c.SendByte(reg);
      i2c.stop();
      i2c.start(); // Data read to retrieve the data from the set address
      i2c.SendByte((SI5351_ADDR << 1) | 1);
      uint8_t data = i2c.RecvByte(true);
      i2c.stop();
      return data;
    }
    void powerDown() {
      SendRegister(3, 0b11111111); // Disable all CLK outputs
      SendRegister(24, 0b00010000); // Disable state: CLK2 HIGH state, CLK0 & CLK1 LOW state when disabled; CLK2 needs to be in HIGH state to make sure that cap to gate is already charged, preventing "exponential pulse is caused by CLK2, which had been at 0v whilst it was disabled, suddenly generating a 5vpp waveform, which is “added to” the 0v filtered PWM output and causing the output fets to be driven with the full 5v pp.", see: https://forum.dl2man.de/viewtopic.php?t=146&p=1307#p1307
      SendRegister(25, 0b00000000); // Disable state: LOW state when disabled
      SendRegister(25, 0b00000000); // Disable state: LOW state when disabled
      for (int addr = 16; addr != 24; addr++) SendRegister(addr, 0b10000000); // Conserve power when output is disabled
      SendRegister(187, 0);        // Disable fanout (power-safe)
      // To initialise things as they should:
      SendRegister(149, 0);        // Disable spread spectrum enable
      SendRegister(183, 0b11010010);  // Internal CL = 10 pF (default)
    }
#define SI_CLK_OE 3

};
static SI5351 si5351;
// */

/*
  class SI5351 : public I2C {
  public:
  #define SI_I2C_ADDR 0x60  // SI5351A I2C address: 0x60 for SI5351A-B-GT; 0x62 for SI5351A-B-04486-GT; 0x6F for SI5351A-B02075-GT; see here for other variants: https://www.silabs.com/TimingUtility/timing-download-document.aspx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
  #define SI_CLK_OE 3     // Register definitions
  #define SI_CLK0_CONTROL 16
  #define SI_CLK1_CONTROL 17
  #define SI_CLK2_CONTROL 18
  #define SI_SYNTH_PLL_A 26
  #define SI_SYNTH_PLL_B 34
  #define SI_SYNTH_MS_0 42
  #define SI_SYNTH_MS_1 50
  #define SI_SYNTH_MS_2 58
  #define SI_CLK0_PHOFF 165
  #define SI_CLK1_PHOFF 166
  #define SI_CLK2_PHOFF 167
  #define SI_PLL_RESET 177
  #define SI_MS_INT 0b01000000  // Clock control
  #define SI_CLK_SRC_PLL_A 0b00000000
  #define SI_CLK_SRC_PLL_B 0b00100000
  #define SI_CLK_SRC_MS 0b00001100
  #define SI_CLK_IDRV_8MA 0b00000011
  #define SI_CLK_INV 0b00010000
  volatile uint32_t fxtal = 27004300;  //myqcx1:27003980 myqcx2:27004900  Actual crystal frequency of 27MHz XTAL2 for CL = 10pF (default), calibrate your QCX 27MHz crystal frequency here
  #define SI_PLL_FREQ (16*fxtal)  //900000000, with 432MHz(=16*27M) PLL freq, usable range is 3.46..100MHz

  volatile uint8_t prev_divider;
  volatile int32_t raw_freq;
  volatile uint8_t divider;  // note: because of int8 only freq > 3.6MHz can be covered for R_DIV=1
  volatile uint8_t mult;
  volatile uint8_t pll_regs[8];
  volatile int32_t iqmsa;
  volatile int32_t pll_freq;   // temporary

  SI5351(){
   init();
   iqmsa = 0;
  }
  uint8_t RecvRegister(uint8_t reg)
  {
   // Data write to set the register address
   start();
   SendByte(SI_I2C_ADDR << 1);
   SendByte(reg);
   stop();
   // Data read to retrieve the data from the set address
   start();
   SendByte((SI_I2C_ADDR << 1) | 1);
   uint8_t data = RecvByte(true);
   stop();
   return data;
  }
  void SendRegister(uint8_t reg, uint8_t data)
  {
   start();
   SendByte(SI_I2C_ADDR << 1);
   SendByte(reg);
   SendByte(data);
   stop();
  }
  // Set up MultiSynth for register reg=MSNA, MNSB, MS0-5 with fractional divider, num and denom and R divider (for MSn, not for MSNA, MSNB)
  // divider is 15..90 for MSNA, MSNB,  divider is 8..900 (and in addition 4,6 for integer mode) for MS[0-5]
  // num is 0..1,048,575 (0xFFFFF)
  // denom is 0..1,048,575 (0xFFFFF)
  // num = 0, denom = 1 forces an integer value for the divider
  // r_div = 1..128 (1,2,4,8,16,32,64,128)
  void SetupMultisynth(uint8_t reg, uint8_t divider, uint32_t num, uint32_t denom, uint8_t r_div)
  {
   uint32_t P1; // Synth config register P1
   uint32_t P2; // Synth config register P2
   uint32_t P3; // Synth config register P3

   P1 = (uint32_t)(128 * ((float)num / (float)denom));
   P1 = (uint32_t)(128 * (uint32_t)(divider) + P1 - 512);
   P2 = (uint32_t)(128 * ((float)num / (float)denom));
   P2 = (uint32_t)(128 * num - denom * P2);
   P3 = denom;

   SendRegister(reg + 0, (P3 & 0x0000FF00) >> 8);
   SendRegister(reg + 1, (P3 & 0x000000FF));
   SendRegister(reg + 2, (P1 & 0x00030000) >> 16 | ((int)log2(r_div) << 4) );
   SendRegister(reg + 3, (P1 & 0x0000FF00) >> 8);
   SendRegister(reg + 4, (P1 & 0x000000FF));
   SendRegister(reg + 5, ((P3 & 0x000F0000) >> 12) | ((P2 & 0x000F0000) >> 16));
   SendRegister(reg + 6, (P2 & 0x0000FF00) >> 8);
   SendRegister(reg + 7, (P2 & 0x000000FF));
  }
  inline void SendPLLRegisterBulk()  // fast freq change of PLLB, takes about [ 2 + 7*(8+1) + 2 ] / 840000 = 80 uS
  {
   start();
   SendByte(SI_I2C_ADDR << 1);
   SendByte(SI_SYNTH_PLL_A + 3);  // Skip the first three pll_regs bytes (first two always 0xFF and third not often changing
   //SendByte(SI_SYNTH_PLL_B + 3);  // Skip the first three pll_regs bytes (first two always 0xFF and third not often changing
   SendByte(pll_regs[3]);
   SendByte(pll_regs[4]);
   SendByte(pll_regs[5]);
   SendByte(pll_regs[6]);
   SendByte(pll_regs[7]);
   stop();
  }

  #define FAST __attribute__((optimize("Ofast")))

  // this function relies on cached (global) variables: divider, mult, raw_freq, pll_regs
  inline void FAST freq_calc_fast(int16_t freq_offset)
  { // freq_offset is relative to freq set in freq(freq)
   // uint32_t num128 = ((divider * (raw_freq + offset)) % fxtal) * (float)(0xFFFFF * 128) / fxtal;
   // Above definition (for fxtal=27.00491M) can be optimized by pre-calculating factor (0xFFFFF*128)/fxtal (=4.97) as integer constant (5) and
   // substracting the rest error factor (0.03). Note that the latter is shifted left (0.03<<6)=2, while the other term is shifted right (>>6)
   register int32_t z = ((divider * (raw_freq + freq_offset)) % fxtal);
   register int32_t z2 = -(z >> 5);
   int32_t num128 = (z * 5) + z2;

   // Set up specified PLL with mult, num and denom: mult is 15..90, num128 is 0..128*1,048,575 (128*0xFFFFF), denom is 0..1,048,575 (0xFFFFF)
   uint32_t P1 = 128 * mult + (num128 / 0xFFFFF) - 512;
   uint32_t P2 = num128 % 0xFFFFF;
   //pll_regs[0] = 0xFF;
   //pll_regs[1] = 0xFF;
   //pll_regs[2] = (P1 >> 14) & 0x0C;
   pll_regs[3] = P1 >> 8;
   pll_regs[4] = P1;
   pll_regs[5] = 0xF0 | (P2 >> 16);
   pll_regs[6] = P2 >> 8;
   pll_regs[7] = P2;
  }
  uint16_t div(uint32_t num, uint32_t denom, uint32_t* b, uint32_t* c)
  { // returns a + b / c = num / denom, where a is the integer part and b and c is the optional fractional part 20 bits each (range 0..1048575)
   uint16_t a = num / denom;
   if(b && c){
     uint64_t l = num % denom;
     l <<= 20; l--;  // l *= 1048575;
     l /= denom;     // normalize
      b = l;
      c = 0xFFFFF;    // for simplicity set c to the maximum 1048575
   }
   return a;
  }
  void freq(uint32_t freq, uint8_t i, uint8_t q)
  { // Fout = Fvco / (R * [MSx_a + MSx_b/MSx_c]),  Fvco = Fxtal * [MSPLLx_a + MSPLLx_b/MSPLLx_c]; MSx as integer reduce spur
   //uint8_t r_div = (freq > (SI_PLL_FREQ/256/1)) ? 1 : (freq > (SI_PLL_FREQ/256/32)) ? 32 : 128; // helps divider to be in range
   uint8_t r_div = (freq < 500000) ? 128 : 1;
   freq *= r_div;  // take r_div into account, now freq is in the range 1MHz to 150MHz
   raw_freq = freq;   // cache frequency generated by PLL and MS stages (excluding R divider stage); used by freq_calc_fast()

   divider = SI_PLL_FREQ / freq;  // Calculate the division ratio. 900,000,000 is the maximum internal PLL freq (official range 600..900MHz but can be pushed to 300MHz..~1200Mhz)
   if(divider % 2) divider--;  // divider in range 8.. 900 (including 4,6 for integer mode), even numbers preferred. Note that uint8 datatype is used, so 254 is upper limit
   if( (divider * (freq - 5000) / fxtal) != (divider * (freq + 5000) / fxtal) ) divider -= 2; // Test if multiplier remains same for freq deviation +/- 5kHz, if not use different divider to make same
   pll_freq = divider * freq; // Calculate the pll_freq: the divider * desired output freq
   uint32_t num, denom;
   mult = div(pll_freq, fxtal, &num, &denom); // Determine the mult to get to the required pll_freq (in the range 15..90)

   // Set up specified PLL with mult, num and denom: mult is 15..90, num is 0..1,048,575 (0xFFFFF), denom is 0..1,048,575 (0xFFFFF)
   // Set up PLL A and PLL B with the calculated  multiplication ratio
   SetupMultisynth(SI_SYNTH_PLL_A, mult, num, denom, 1);
   SetupMultisynth(SI_SYNTH_PLL_B, mult, num, denom, 1);
   //if(denom == 1) SendRegister(22, SI_MSx_INT); // FBA_INT: MSNA operates in integer mode
   //if(denom == 1) SendRegister(23, SI_MSx_INT); // FBB_INT: MSNB operates in integer mode
   // Set up MultiSynth 0,1,2 with the calculated divider, from 4, 6..1800.
   // The final R division stage can divide by a power of two, from 1..128
   // if you want to output frequencies below 1MHz, you have to use the final R division stage
   SetupMultisynth(SI_SYNTH_MS_0, divider, 0, 1, r_div);
   SetupMultisynth(SI_SYNTH_MS_1, divider, 0, 1, r_div);
   SetupMultisynth(SI_SYNTH_MS_2, divider, 0, 1, r_div);
   //if(prev_divider != divider){ lcd.setCursor(0, 0); lcd.print(divider); lcd.print(F("     "));
   // Set I/Q phase
   SendRegister(SI_CLK0_PHOFF, i * divider / 90); // one LSB equivalent to a time delay of Tvco/4 range 0..127
   SendRegister(SI_CLK1_PHOFF, q * divider / 90); // one LSB equivalent to a time delay of Tvco/4 range 0..127
   // Switch on the CLK0, CLK1 output to be PLL A and set multiSynth0, multiSynth1 input (0x0F = SI_CLK_SRC_MS | SI_CLK_IDRV_8MA)
   SendRegister(SI_CLK0_CONTROL, 0x0F | SI_MS_INT | SI_CLK_SRC_PLL_A);
   SendRegister(SI_CLK1_CONTROL, 0x0F | SI_MS_INT | SI_CLK_SRC_PLL_A);
   // Switch on the CLK2 output to be PLL B and set multiSynth2 input
   SendRegister(SI_CLK2_CONTROL, 0x0F | SI_MS_INT | SI_CLK_SRC_PLL_B);
   SendRegister(SI_CLK_OE, 0b11111100); // Enable CLK1|CLK0
   // Reset the PLL. This causes a glitch in the output. For small changes to
   // the parameters, you don't need to reset the PLL, and there is no glitch
   if((abs(pll_freq - iqmsa) > 16000000L) || divider != prev_divider){
     iqmsa = pll_freq;
     prev_divider = divider;
     SendRegister(SI_PLL_RESET, 0xA0);
   }
   //SendRegister(24, 0b00000000); // CLK3-0 Disable State: CLK2=0 (BE CAREFUL TO CHANGE THIS!!!), CLK1/0=00 -> IC4-X0 selected -> 2,5V on IC5A/3(+), when IC5/2(-) leaks down below 2.5V -> 12V on IC5A/1, IC6A/2(-) -> 0V on IC6A/1, AUDIO2
  }
  void alt_clk2(uint32_t freq)
  {
   uint32_t num, denom;
   uint16_t mult = div(pll_freq, freq, &num, &denom);

   SetupMultisynth(SI_SYNTH_MS_2, mult, num, denom, 1);

   // Switch on the CLK2 output to be PLL A and set multiSynth2 input
   SendRegister(SI_CLK2_CONTROL, 0x0F | SI_CLK_SRC_PLL_A);

   SendRegister(SI_CLK_OE, 0b11111000); // Enable CLK2|CLK1|CLK0

   //SendRegister(SI_CLK0_PHOFF, 0 * divider / 90); // one LSB equivalent to a time delay of Tvco/4 range 0..127
   //SendRegister(SI_CLK1_PHOFF, 90 * divider / 90); // one LSB equivalent to a time delay of Tvco/4 range 0..127
   //SendRegister(SI_CLK2_PHOFF, 45 * divider / 90); // one LSB equivalent to a time delay of Tvco/4 range 0..127
   //SendRegister(SI_PLL_RESET, 0xA0);
  }
  void powerDown()
  {
   SendRegister(SI_CLK0_CONTROL, 0b10000000);  // Conserve power when output is disabled
   SendRegister(SI_CLK1_CONTROL, 0b10000000);
   SendRegister(SI_CLK2_CONTROL, 0b10000000);
   SendRegister(19, 0b10000000);
   SendRegister(20, 0b10000000);
   SendRegister(21, 0b10000000);
   SendRegister(22, 0b10000000);
   SendRegister(23, 0b10000000);
   SendRegister(SI_CLK_OE, 0b11111111); // Disable all CLK outputs
  }
  };
  static SI5351 si5351;
*/

#ifdef LPF_SWITCHING_DL2MAN_USDX_REV1
class PCA9536 {
  public:
#define PCA9536_ADDR  0x41  // PCA9536   https://www.ti.com/lit/ds/symlink/pca9536.pdf
    inline void SendRegister(uint8_t reg, uint8_t val) {
      i2c.begin();
      i2c.beginTransmission(PCA9536_ADDR);
      i2c.write(reg);
      i2c.write(val);
      i2c.endTransmission();
    }
    inline void init() {
      SendRegister(0x03, 0x00);  // configuration cmd: IO0-IO7 as output
    }
    inline void write(uint8_t data) {
      init();  // output port cmd: write bits D7-D0 to IO7-IO0
      SendRegister(0x01, data);
    }
};
PCA9536 ioext;

void set_latch(uint8_t io) { // reset all latches and set latch k to corresponding GPIO, all relays share a common (ground) GPIO
#define LATCH_TIME  15   // set/reset time latch relay
  for (int i = 0; i != 8; i++) {
    ioext.write( (~(1 << i)) | 0x01);
    delay(LATCH_TIME);
  } ioext.write(0x00); // reset all latches
  ioext.write((1 << io) | 0x00); delay(LATCH_TIME); ioext.write(0x00); // set latch wired to io port
}

static uint8_t prev_lpf_io = 0xff;
inline void set_lpf(uint8_t f) {
  //  uint8_t lpf_io = (f >  8) ? 1 : (f > 4) ? 2 : /*(f <= 4)*/ 3; // cut-off freq in MHz to IO port of LPF relay
    uint8_t lpf_io = (f >  15) ? 2 : (f > 9) ? 1 : /*(f <= 4)*/ 3; // cut-off freq in MHz to IO port of LPF relay
  if (prev_lpf_io != lpf_io) {
    prev_lpf_io = lpf_io;
    set_latch(lpf_io);
  };  // set relay
}
#endif  //LPF_SWITCHING_DL2MAN_USDX_REV1

#if defined(LPF_SWITCHING_DL2MAN_USDX_REV3) || defined(LPF_SWITCHING_DL2MAN_USDX_REV2) || defined(LPF_SWITCHING_DL2MAN_USDX_REV2_BETA)
class IOExpander16 {
  public:
#ifdef LPF_SWITCHING_DL2MAN_USDX_REV2_BETA
#define IOEXP16_ADDR  0x20  // PCA9539 with A1..A0 set to 0     https://www.nxp.com/docs/en/data-sheet/PCA9539_PCA9539R.pdf
#endif
#ifdef LPF_SWITCHING_DL2MAN_USDX_REV2
#define IOEXP16_ADDR  0x20  // TCA/PCA9555 with A2=1 A1..A0=0   https://www.ti.com/lit/ds/symlink/tca9555.pdf
#endif
#ifdef LPF_SWITCHING_DL2MAN_USDX_REV3
#define IOEXP16_ADDR  0x20  // TCA/PCA9555 with A2=0 A1..A0=0   https://www.ti.com/lit/ds/symlink/tca9555.pdf
#endif
    inline void SendRegister(uint8_t reg, uint8_t val) {
      i2c.begin();
      i2c.beginTransmission(IOEXP16_ADDR);
      i2c.write(reg);
      i2c.write(val);
      i2c.endTransmission();
    }
    inline void init() {
      write(0U);  //IO0, IO1 as input, IO0 to 0, IO0 as output, IO1 to 0, IO1 as output
    }
    inline void write(uint16_t data) {
      SendRegister(0x07, 0xff);   // output port cmd: write bits D15-D0 to IO1.7-0.0;
      SendRegister(0x06, 0xff);/*Common last!*/ SendRegister(0x02, data);
      SendRegister(0x06, 0x00);/*Common first!*/ SendRegister(0x03, data >> 8);
      SendRegister(0x07, 0x00);
    }
};
IOExpander16 ioext;
enum gpioext_t { IO0_0, IO0_1, IO0_2, IO0_3, IO0_4, IO0_5, IO0_6, IO0_7, IO1_0, IO1_1, IO1_2, IO1_3, IO1_4, IO1_5, IO1_6, IO1_7 };

void set_latch(uint8_t io, uint8_t common_io, bool latch = true) { // reset all latches and set latch k to corresponding GPIO, all relays share a common (ground) GPIO
#define LATCH_TIME  30   // set/reset time latch relay
  if (latch) {
    ioext.write((1U << io) | 0x0000); delay(LATCH_TIME); ioext.write(0x0000); // set latch wired to io port
  } else {
    if (io == 0xff) {
      ioext.init();  // reset all latches
      for (int io = 0; io != 16; io++) set_latch(io, common_io, latch);
    }
    else {
      ioext.write( (~(1U << io)) | (1U << common_io));  // reset latch wired to io port
      delay(LATCH_TIME);
      ioext.write(0x0000);
    }
  }
}

static uint8_t prev_lpf_io = 0xff; // inits and resets all latches
inline void set_lpf(uint8_t f) {
#ifdef LPF_SWITCHING_DL2MAN_USDX_REV3
  uint8_t lpf_io = (f > 26) ? IO0_6 : (f > 20) ? IO0_5 : (f > 17) ? IO0_4 : (f > 12) ? IO0_3 : (f > 8) ? IO0_2 : (f > 5) ? IO0_1 : (f > 4) ? IO0_0 : /*(f <= 4)*/ IO1_7; // cut-off freq in MHz to IO port of LPF relay
#ifndef LPF_SWITCHING_DL2MAN_USDX_REV3_NOLATCH
  if (prev_lpf_io != lpf_io) {
    set_latch(prev_lpf_io, IO0_7, false);
    set_latch(lpf_io, IO0_7);
    prev_lpf_io = lpf_io;
  };  // set relay (latched)
#else
  if (prev_lpf_io != lpf_io) {
    ioext.write(1U << lpf_io);
    prev_lpf_io = lpf_io;
  };  // set relay (non-latched)
#endif //LPF_SWITCHING_DL2MAN_USDX_REV3_NOLATCH
#else //LPF_SWITCHING_DL2MAN_USDX_REV2 LPF_SWITCHING_DL2MAN_USDX_REV2_BETA
//  uint8_t lpf_io = (f > 12) ? IO0_3 : (f > 8) ? IO0_5 : (f > 5) ? IO0_7 : (f > 4) ? IO1_1 : /*(f <= 4)*/ IO1_3; // cut-off freq in MHz to IO port of LPF relay
    uint8_t lpf_io = (f > 25) ? IO1_1 : (f > 20) ? IO1_2 : (f > 13) ? IO1_3 : /*(f <= 4)*/ IO1_4; // cut-off freq in MHz to IO port of LPF relay   //4波段V3.4
//    uint8_t lpf_io = (f > 25) ? IO0_7 : (f > 20) ? IO0_6 : (f > 13) ? IO0_5 : /*(f <= 4)*/ IO0_4; // cut-off freq in MHz to IO port of LPF relay   //4波段V3.0
  if (prev_lpf_io != lpf_io) {
//    set_latch(prev_lpf_io, IO0_1, false);
//    set_latch(lpf_io, IO0_1);
    set_latch(prev_lpf_io, IO1_5, false);    //4波段V3.4
    set_latch(lpf_io, IO1_5);               //4波段V3.4
//    set_latch(prev_lpf_io, IO0_3, false);      //4波段V3.0
//    set_latch(lpf_io, IO0_3);                 //4波段V3.0
    prev_lpf_io = lpf_io;
  };  // set relay

#endif
}
#endif  //LPF_SWITCHING_DL2MAN_USDX_REV3 LPF_SWITCHING_DL2MAN_USDX_REV2 REV2_BETA

#ifdef LPF_SWITCHING_WB2CBA_USDX_OCTOBAND
class MCP23008 {
  public:
#define MCP23008_ADDR  0x20  // MCP23008 with A1..A0 set to 0   https://ww1.microchip.com/downloads/en/DeviceDoc/21919e.pdf
    inline void SendRegister(uint8_t reg, uint8_t val) {
      i2c.begin();
      i2c.beginTransmission(MCP23008_ADDR);
      i2c.write(reg);
      i2c.write(val);
      i2c.endTransmission();
    }
    inline void init() {
      SendRegister(0x09, 0x00);  //GP0-7 to 0, GP0-7 as output
      SendRegister(0x00, 0x00);
    }
    inline void write(uint16_t data) {
      SendRegister(0x09, data);  // output port cmd: write bits D7-D0 to GP7-GP0
    }
};
MCP23008 ioext;

static uint8_t prev_lpf_io = 0xff; // inits and resets all latches
inline void set_lpf(uint8_t f) {
  uint8_t lpf_io = (f > 26) ? 7 : (f > 20) ? 6 : (f > 17) ? 5 : (f > 12) ? 4 : (f > 8) ? 3 : (f > 6) ? 2 : (f > 4) ? 1 : /*(f <= 4)*/ 0; // cut-off freq in MHz to IO port of LPF relay
  if (prev_lpf_io == 0xff) {
    ioext.init();
  }
  if (prev_lpf_io != lpf_io) {
    ioext.write(1U << lpf_io);
    prev_lpf_io = lpf_io;
  };  // set relay (non-latched)
}
#endif  //LPF_SWITCHING_WB2CBA_USDX_OCTOBAND

#if defined(LPF_SWITCHING_PE1DDA_USDXDUO)
inline void set_lpf(uint8_t f) {
  pinMode(PD5, OUTPUT);
  digitalWrite(PD5, (f >= LPF_SWITCHING_PE1DDA_USDXDUO));
}
#endif  //LPF_SWITCHING_PE1DDA_USDXDUO

#if !defined(LPF_SWITCHING_DL2MAN_USDX_REV1) && !defined(LPF_SWITCHING_DL2MAN_USDX_REV2_BETA) && !defined(LPF_SWITCHING_DL2MAN_USDX_REV2) && !defined(LPF_SWITCHING_DL2MAN_USDX_REV3) && !defined(LPF_SWITCHING_WB2CBA_USDX_OCTOBAND) && !defined(LPF_SWITCHING_PE1DDA_USDXDUO)
inline void set_lpf(uint8_t f) {} // dummy
#endif

#ifdef DEBUG
static uint32_t sr = 0;
static uint32_t cpu_load = 0;
volatile uint16_t param_a = 0;  // registers for debugging, testing and experimental purposes
volatile int16_t param_b = 0;
volatile int16_t param_c = 0;
#endif

enum dsp_cap_t { ANALOG, DSP, SDR };
#ifdef QCX
uint8_t dsp_cap = 0;
uint8_t ssb_cap = 0;
#else
// force SSB and SDR capability
const uint8_t ssb_cap = 1;
const uint8_t dsp_cap = SDR;
#endif

enum mode_t { LSB, USB, CW, FM, AM };
volatile uint8_t mode = USB;
volatile uint16_t numSamples = 0;

volatile uint8_t tx = 0;
volatile uint8_t filt = 0;

inline void _vox(bool trigger)
{
  if (trigger) {
    tx = (tx) ? 254 : 255; // hangtime = 255 / 4402 = 58ms (the time that TX at least stays on when not triggered again). tx == 255 when triggered first, 254 follows for subsequent triggers, until tx is off.
  } else {
    if (tx) tx--;
  }
}

#define F_SAMP_TX 4800 //4810 //4805 // 4402 // (Design) ADC sample-rate; is best a multiple of _UA and fits exactly in OCR2A = ((F_CPU / 64) / F_SAMP_TX) - 1 , should not exceed CPU utilization
#if(F_MCU != 20000000)
const int16_t _F_SAMP_TX = (F_MCU * 4800LL / 20000000);  // Actual ADC sample-rate; used for phase calculations
#else
#define _F_SAMP_TX  F_SAMP_TX
#endif
#define _UA  600 //=(_FSAMP_TX)/8 //(_F_SAMP_TX)      //360  // unit angle; integer representation of one full circle turn or 2pi radials or 360 degrees, should be a integer divider of F_SAMP_TX and maximized to have higest precision
#define MAX_DP  ((filt == 0) ? _UA : (filt == 3) ? _UA/4 : _UA/2)     //(_UA/2) // the occupied SSB bandwidth can be further reduced by restricting the maximum phase change (set MAX_DP to _UA/2).
#define CARRIER_COMPLETELY_OFF_ON_LOW  1    // disable oscillator on low amplitudes, to prevent potential unwanted biasing/leakage through PA circuit
#define MULTI_ADC  1  // multiple ADC conversions for more sensitive (+12dB) microphone input
//#define QUAD  1       // invert TX signal for phase changes > 180

inline int16_t arctan3(int16_t q, int16_t i)  // error ~ 0.8 degree
{ // source: [1] http://www-labs.iro.umontreal.ca/~mignotte/IFT2425/Documents/EfficientApproximationArctgFunction.pdf
  //#define _atan2(z)  (_UA/8 + _UA/44) * z  // very much of a simplification...not accurate at all, but fast
#define _atan2(z)  (_UA/8 + _UA/22 - _UA/22 * z) * z  //derived from (5) [1]   note that atan2 can overflow easily so keep _UA low
  //#define _atan2(z)  (_UA/8 + _UA/24 - _UA/24 * z) * z  //derived from (7) [1]
  int16_t r;
  if (abs(q) > abs(i))
    r = _UA / 4 - _atan2(abs(i) / abs(q));        // arctan(z) = 90-arctan(1/z)
  else
    r = (i == 0) ? 0 : _atan2(abs(q) / abs(i));   // arctan(z)
  r = (i < 0) ? _UA / 2 - r : r;                  // arctan(-z) = -arctan(z)
  return (q < 0) ? -r : r;                        // arctan(-z) = -arctan(z)
}

#define magn(i, q) (abs(i) > abs(q) ? abs(i) + abs(q) / 4 : abs(q) + abs(i) / 4) // approximation of: magnitude = sqrt(i*i + q*q); error 0.95dB

uint8_t lut[256];
volatile uint8_t amp;
#define MORE_MIC_GAIN   1       // adds more microphone gain, improving overall SSB quality (when speaking further away from microphone)
#ifdef MORE_MIC_GAIN
volatile uint8_t vox_thresh = (1 << 2);
#else
volatile uint8_t vox_thresh = (1 << 1); //(1 << 2);
#endif
volatile uint8_t drive = 2;   // hmm.. drive>2 impacts cpu load..why?

volatile uint8_t quad = 0;

inline int16_t ssb(int16_t in)
{
  static int16_t dc, z1;

  int16_t i, q;
  uint8_t j;
  static int16_t v[16];
  for (j = 0; j != 15; j++) v[j] = v[j + 1];
#ifdef MORE_MIC_GAIN
  //#define DIG_MODE  // optimization for digital modes: for super flat TX spectrum, (only down < 100Hz to cut-off DC components)
#ifdef DIG_MODE
  int16_t ac = in;
  dc = (ac + (7) * dc) / (7 + 1);  // hpf: slow average
  v[15] = (ac - dc) / 2;           // hpf (dc decoupling)  (-6dB gain to compensate for DC-noise)
#else
  int16_t ac = in * 2;             //   6dB gain (justified since lpf/hpf is losing -3dB)
  ac = ac + z1;                    // lpf
  z1 = (in - (2) * z1) / (2 + 1);  // lpf: notch at Fs/2 (alias rejecting)
  dc = (ac + (2) * dc) / (2 + 1);  // hpf: slow average
  v[15] = (ac - dc);               // hpf (dc decoupling)
#endif //DIG_MODE
  i = v[7] * 2;  // 6dB gain for i, q  (to prevent quanitization issues in hilbert transformer and phase calculation, corrected for magnitude calc)
  q = ((v[0] - v[14]) * 2 + (v[2] - v[12]) * 8 + (v[4] - v[10]) * 21 + (v[6] - v[8]) * 16) / 64 + (v[6] - v[8]); // Hilbert transform, 40dB side-band rejection in 400..1900Hz (@4kSPS) when used in image-rejection scenario; (Hilbert transform require 5 additional bits)

  uint16_t _amp = magn(i / 2, q / 2);  // -6dB gain (correction)
#else  // !MORE_MIC_GAIN
  //dc += (in - dc) / 2;       // fast moving average
  dc = (in + dc) / 2;        // average
  int16_t ac = (in - dc);   // DC decoupling
  //v[15] = ac;// - z1;        // high-pass (emphasis) filter
  v[15] = (ac + z1);// / 2;           // low-pass filter with notch at Fs/2
  z1 = ac;

  i = v[7];
  q = ((v[0] - v[14]) * 2 + (v[2] - v[12]) * 8 + (v[4] - v[10]) * 21 + (v[6] - v[8]) * 15) / 128 + (v[6] - v[8]) / 2; // Hilbert transform, 40dB side-band rejection in 400..1900Hz (@4kSPS) when used in image-rejection scenario; (Hilbert transform require 5 additional bits)

  uint16_t _amp = magn(i, q);
#endif  // MORE_MIC_GAIN

#ifdef CARRIER_COMPLETELY_OFF_ON_LOW
  _vox(_amp > vox_thresh);
#else
  if (vox) _vox(_amp > vox_thresh);
#endif
  //_amp = (_amp > vox_thresh) ? _amp : 0;   // vox_thresh = 4 is a good setting
  //if(!(_amp > vox_thresh)) return 0;

  _amp = _amp << (drive);
  _amp = ((_amp > 255) || (drive == 8)) ? 255 : _amp; // clip or when drive=8 use max output
  amp = (tx) ? lut[_amp] : 0;

  static int16_t prev_phase;
  int16_t phase = arctan3(q, i);

  int16_t dp = phase - prev_phase;  // phase difference and restriction
  //dp = (amp) ? dp : 0;  // dp = 0 when amp = 0
  prev_phase = phase;

  if (dp < 0) dp = dp + _UA; // make negative phase shifts positive: prevents negative frequencies and will reduce spurs on other sideband
#ifdef QUAD
  if (dp >= (_UA / 2)) {
    dp = dp - _UA / 2;
    quad = !quad;
  }
#endif

#ifdef MAX_DP
  if (dp > MAX_DP) { // dp should be less than half unit-angle in order to keep frequencies below F_SAMP_TX/2
    prev_phase = phase - (dp - MAX_DP);  // substract restdp
    dp = MAX_DP;
  }
#endif
  if (mode == USB)
    return dp * ( _F_SAMP_TX / _UA); // calculate frequency-difference based on phase-difference
  else
    return dp * (-_F_SAMP_TX / _UA);
}

#define MIC_ATTEN  0  // 0*6dB attenuation (note that the LSB bits are quite noisy)
volatile int8_t mox = 0;
volatile int8_t volume = 7;

// This is the ADC ISR, issued with sample-rate via timer1 compb interrupt.
// It performs in real-time the ADC sampling, calculation of SSB phase-differences, calculation of SI5351 frequency registers and send the registers to SI5351 over I2C.
static int16_t _adc;
void dsp_tx()
{ // jitter dependent things first
#ifdef MULTI_ADC  // SSB with multiple ADC conversions:
  int16_t adc;                         // current ADC sample 10-bits analog input, NOTE: first ADCL, then ADCH
  adc = ADC;
  ADCSRA |= (1 << ADSC);
  //OCR1BL = amp;                        // submit amplitude to PWM register (actually this is done in advance (about 140us) of phase-change, so that phase-delays in key-shaping circuit filter can settle)
  si5351.SendPLLRegisterBulk();       // submit frequency registers to SI5351 over 731kbit/s I2C (transfer takes 64/731 = 88us, then PLL-loopfilter probably needs 50us to stabalize)
#ifdef QUAD
#ifdef TX_CLK0_CLK1
  si5351.SendRegister(16, (quad) ? 0x1f : 0x0f);  // Invert/non-invert CLK0 in case of a huge phase-change
  si5351.SendRegister(17, (quad) ? 0x1f : 0x0f);  // Invert/non-invert CLK1 in case of a huge phase-change
#else
  si5351.SendRegister(18, (quad) ? 0x1f : 0x0f);  // Invert/non-invert CLK2 in case of a huge phase-change
#endif
#endif //QUAD
  OCR1BL = amp;                      // submit amplitude to PWM register (takes about 1/32125 = 31us+/-31us to propagate) -> amplitude-phase-alignment error is about 30-50us
  adc += ADC;
  ADCSRA |= (1 << ADSC);  // causes RFI on QCX-SSB units (not on units with direct biasing); ENABLE this line when using direct biasing!!
  int16_t df = ssb(_adc >> MIC_ATTEN); // convert analog input into phase-shifts (carrier out by periodic frequency shifts)
  adc += ADC;
  ADCSRA |= (1 << ADSC);
  si5351.freq_calc_fast(df);           // calculate SI5351 registers based on frequency shift and carrier frequency
  adc += ADC;
  ADCSRA |= (1 << ADSC);
  //_adc = (adc/4 - 512);
#define AF_BIAS   32
  _adc = (adc / 4 - (512 - AF_BIAS));      // now make sure that we keep a postive bias offset (to prevent the phase swapping 180 degrees and potentially causing negative feedback (RFI)
#else  // SSB with single ADC conversion:
  ADCSRA |= (1 << ADSC);    // start next ADC conversion (trigger ADC interrupt if ADIE flag is set)
  //OCR1BL = amp;                        // submit amplitude to PWM register (actually this is done in advance (about 140us) of phase-change, so that phase-delays in key-shaping circuit filter can settle)
  si5351.SendPLLRegisterBulk();       // submit frequency registers to SI5351 over 731kbit/s I2C (transfer takes 64/731 = 88us, then PLL-loopfilter probably needs 50us to stabalize)
  OCR1BL = amp;                        // submit amplitude to PWM register (takes about 1/32125 = 31us+/-31us to propagate) -> amplitude-phase-alignment error is about 30-50us
  int16_t adc = ADC - 512; // current ADC sample 10-bits analog input, NOTE: first ADCL, then ADCH
  int16_t df = ssb(adc >> MIC_ATTEN);  // convert analog input into phase-shifts (carrier out by periodic frequency shifts)
  si5351.freq_calc_fast(df);           // calculate SI5351 registers based on frequency shift and carrier frequency
#endif

#ifdef CARRIER_COMPLETELY_OFF_ON_LOW
  if (tx == 1) {
    OCR1BL = 0;  // disable carrier
    si5351.SendRegister(SI_CLK_OE, TX0RX0);
  }
  if (tx == 255) {
    si5351.SendRegister(SI_CLK_OE, TX1RX0);  // enable carrier
  }
#endif

#ifdef MOX_ENABLE
  if (!mox) return;
  OCR1AL = (adc << (mox - 1)) + 128; // TX audio monitoring
#endif
}

volatile uint16_t acc;
volatile uint32_t cw_offset;
volatile uint8_t tone_vol = 12;
volatile uint8_t cw_tone = 1;
const uint32_t tones[] = { F_MCU * 700ULL / 20000000, F_MCU * 600ULL / 20000000, F_MCU * 700ULL / 20000000};

volatile int8_t p_sin = 0;     // initialized with A*sin(0) = 0
volatile int8_t n_cos = 448 / 4; // initialized with A*cos(t) = A
inline void process_minsky() // Minsky circle sample [source: https://www.cl.cam.ac.uk/~am21/hakmemc.html, ITEM 149]: p_sin+=n_cos*2*PI*f/fs; n_cos-=p_sin*2*PI*f/fs;
{
  int8_t alpha127 = tones[cw_tone]/*cw_offset*/ * 798 / _F_SAMP_TX;  // alpha = f_tone * 2 * pi / fs
  p_sin += alpha127 * n_cos / 127;
  n_cos -= alpha127 * p_sin / 127;
}

// CW Key-click shaping, ramping up/down amplitude with sample-interval of 60us. Tnx: Yves HB9EWY https://groups.io/g/ucx/message/5107
const uint8_t ramp[] PROGMEM = { 255, 254, 252, 249, 245, 239, 233, 226, 217, 208, 198, 187, 176, 164, 152, 139, 127, 115, 102, 90, 78, 67, 56, 46, 37, 28, 21, 15, 9, 5, 2 }; // raised-cosine(i) = 255 * sq(cos(HALF_PI * i/32))

void dummy()
{
}

void dsp_tx_cw()
{ // jitter dependent things first
#ifdef KEY_CLICK
  if (OCR1BL < lut[255]) { //check if already ramped up: ramp up of amplitude
    for (uint16_t i = 31; i != 0; i--) {  // soft rising slope against key-clicks
      OCR1BL = lut[pgm_read_byte_near(&ramp[i-1])];
      delayMicroseconds(60);
    }
  }
#endif // KEY_CLICK
  OCR1BL = lut[255];

  process_minsky();
  OCR1AL = ( tone_vol ? (p_sin >> (16 - tone_vol )) : 0 ) + 128;    //CW 侧音
  //  OCR1AL = (p_sin >> (16 - volume)) + 128;
}

void dsp_tx_am()
{ // jitter dependent things first
  ADCSRA |= (1 << ADSC);    // start next ADC conversion (trigger ADC interrupt if ADIE flag is set)
  OCR1BL = amp;                        // submit amplitude to PWM register (actually this is done in advance (about 140us) of phase-change, so that phase-delays in key-shaping circuit filter can settle)
  int16_t adc = ADC - 512; // current ADC sample 10-bits analog input, NOTE: first ADCL, then ADCH
  int16_t in = (adc >> MIC_ATTEN);
  in = in << (drive - 4);
  //static int16_t dc;
  //dc += (in - dc) / 2;
  //in = in - dc;     // DC decoupling
#define AM_BASE 32
  in = max(0, min(255, (in + AM_BASE)));
  amp = in; // lut[in];
}

void dsp_tx_fm()
{ // jitter dependent things first
  ADCSRA |= (1 << ADSC);    // start next ADC conversion (trigger ADC interrupt if ADIE flag is set)
  OCR1BL = lut[255];                   // submit amplitude to PWM register (actually this is done in advance (about 140us) of phase-change, so that phase-delays in key-shaping circuit filter can settle)
  si5351.SendPLLRegisterBulk();       // submit frequency registers to SI5351 over 731kbit/s I2C (transfer takes 64/731 = 88us, then PLL-loopfilter probably needs 50us to stabalize)
  int16_t adc = ADC - 512; // current ADC sample 10-bits analog input, NOTE: first ADCL, then ADCH
  int16_t in = (adc >> MIC_ATTEN);
  in = in << (drive);
  int16_t df = in;
  si5351.freq_calc_fast(df);           // calculate SI5351 registers based on frequency shift and carrier frequency
}

#define EA(y, x, one_over_alpha)  (y) = (y) + ((x) - (y)) / (one_over_alpha); // exponental averaging [Lyons 13.33.1]
#define MLEA(y, x, L, M)  (y)  = (y) + ((((x) - (y)) >> (L)) - (((x) - (y)) >> (M))); // multiplierless exponental averaging [Lyons 13.33.1], with alpha=1/2^L - 1/2^M

#ifdef SWR_METER
volatile uint8_t swrmeter = 1;
#endif

const char m2c[] PROGMEM = "~ ETIANMSURWDKGOHVF*L*PJBXCYZQ**54S3***2**+***J16=/***H*7*G*8*90************?_****\"**.****@***'**-********;!*)*****,****:****";

#ifdef CW_MESSAGE
#define MENU_STR  1

uint8_t delayWithKeySense(uint32_t ms) {
  uint32_t event = millis() + ms;
  for (; millis() < event;) {
    wdt_reset();
    if (inv ^ digitalRead(BUTTONS) || !digitalRead(DAH) || !digitalRead(DIT)) {
      for (; inv ^ digitalRead(BUTTONS);) wdt_reset(); // wait until buttons released
      return 1;  // stop when button/key pressed
    }
  }
  return 0;
}
#ifdef CW_MESSAGE_EXT
char cw_msg[6][48] = { "CQ PE1NNN +", "CQ CQ DE PE1NNN PE1NNN +", "GE TKS 5NN 5NN NAME IS GUIDO GUIDO HW?", "FB RPTR TX 5W 5W ANT INV V 73 CUAGN", "73 TU E E", "PE1NNN" };
#else
char cw_msg[1][48] = { "CQ PE1NNN +" };
#endif
uint8_t cw_msg_interval = 5; // number of seconds CW message is repeated
uint32_t cw_msg_event = 0;
uint8_t cw_msg_id = 0; // selected message

int cw_tx(char ch) {   // Transmit message in CW
  char sym;
  for (uint8_t j = 0; (sym = pgm_read_byte_near(m2c + j)); j++) { // lookup msg[i] in m2c, skip if not found
    if (sym == ch) { // found -> transmit CW character j
      wdt_reset();
      uint8_t k = 0x80; for (; !(j & k); k >>= 1); k >>= 1; // shift start of cw code to MSB
      if (k == 0) delay(ditTime * 4); // space -> add word space
      else {
        for (; k; k >>= 1) { // send dit/dah one by one, until everythng is sent
          switch_rxtx(1);  // key-on  tx
          if (delayWithKeySense(ditTime * ((j & k) ? 3 : 1))) {
            switch_rxtx(0);  // symbol: dah or dih length
            return 1;
          }
          switch_rxtx(0);  // key-off tx
          if (delayWithKeySense(ditTime)) return 1;  // add symbol space
        }
        if (delayWithKeySense(ditTime * 2)) return 1; // add letter space
      }
      break; // next character
    }
  }
  return 0;
}

int cw_tx(char* msg) {
  for (uint8_t i = 0; msg[i]; i++) { // loop over message
    lcd.setCursor(0, 0); lcd.print(i); lcd.print("    ");
    if (cw_tx(msg[i])) return 1;
  }
  return 0;
}
#endif // CW_MESSAGE

volatile uint8_t menumode = 0;  // 0=not in menu, 1=selects menu item, 2=selects parameter value

#ifdef CW_DECODER
volatile uint8_t cwdec = 1;
static int32_t avg = 256;
static uint8_t sym;
static uint32_t amp32 = 0;
volatile uint32_t _amp32 = 0;
static char out[] = "                ";
volatile uint8_t cw_event = false;

void printsym(bool submit = true) {
  if (sym < 128) {
    char ch = pgm_read_byte_near(m2c + sym); if (ch != '*') {
#ifdef CW_INTERMEDIATE
      out[15] = ch; cw_event = true; if (submit) {
        for (int i = 0; i != 15; i++) {
          out[i] = out[i + 1];  // update LCD, only shift when submit is true, otherwise update last char only
        } out[15] = ' ';
      }
#else
      for (int i = 0; i != 15; i++) out[i] = out[i + 1]; out[15] = ch; cw_event = true; // update LCD
#endif
    }
  }
  if (submit) sym = 1;
}

bool realstate = LOW;
bool realstatebefore = LOW;
bool filteredstate = LOW;
bool filteredstatebefore = LOW;
uint8_t nbtime = 16;  // 6 // ms noise blanker
uint32_t starttimehigh;
uint32_t highduration;
uint32_t hightimesavg;
uint32_t lowtimesavg;
uint32_t startttimelow;
uint32_t lowduration;
uint32_t laststarttime = 0;
uint8_t wpm = 25;

inline void cw_decode()
{
  int32_t in = _amp32;
  EA(avg, in, (1 << 8));
  realstate = (in > (avg * 1 / 2)); // threshold

  // here we clean up the state with a noise blanker
  if (realstate != realstatebefore) {
    laststarttime = millis();
  }
  //#define NB_SCALED_TO_WPM    1   // Scales noise-blanker timing the actual CW speed; this should reduce errors from noise at low speeds; this may have side-effect with fast speed changes that fast CW will be filtered out
#ifdef NB_SCALED_TO_WPM
  if ((millis() - laststarttime) > min(1200 / (20 * 2), max(1200 / (40 * 2), hightimesavg / 6))) {
#else
  if ((millis() - laststarttime) > nbtime) {
#endif
    if (realstate != filteredstate) {
      filteredstate = realstate;
      //dec2();
    }
  } else avg += avg / 100; // keep threshold above noise spikes (increase threshold with 1%)

  dec2();
  realstatebefore = realstate;
}

//#define NEW_CW  1   // CW decoder portions from by Hjalmar Skovholm Hansen OZ1JHM, source: http://www.skovholm.com/decoder11.ino
#ifdef NEW_CW
void dec2()
{
  // Then we do want to have some durations on high and low
  if (filteredstate != filteredstatebefore) {
    if (menumode == 0) {
      lcd.noCursor();
      lcd.setCursor(15, 1);
      lcd.print((filteredstate) ? 'R' : ' ');
      stepsize_showcursor();
    }

    if (filteredstate == HIGH) {
      starttimehigh = millis();
      lowduration = (millis() - startttimelow);
    }

    if (filteredstate == LOW) {
      startttimelow = millis();
      highduration = (millis() - starttimehigh);
      if (highduration < (2 * hightimesavg) || hightimesavg == 0) {
        hightimesavg = (highduration + hightimesavg + hightimesavg) / 3; // now we know avg dit time ( rolling 3 avg)
      }
      if (highduration > (5 * hightimesavg)) {
        hightimesavg = highduration / 3;   // if speed decrease fast ..
        //hightimesavg = highduration+hightimesavg;     // if speed decrease fast ..
      }
    }
  }

  // now we will check which kind of baud we have - dit or dah, and what kind of pause we do have 1 - 3 or 7 pause, we think that hightimeavg = 1 bit
  if (filteredstate != filteredstatebefore) {
    if (filteredstate == LOW) { //// we did end a HIGH
#define FAIR_WEIGHTING    1
#ifdef FAIR_WEIGHTING
      if (highduration < (hightimesavg + hightimesavg / 2) && highduration > (hightimesavg * 6 / 10)) { /// 0.6 filter out false dits
#else
      if (highduration < (hightimesavg * 2) && highduration > (hightimesavg * 6 / 10)) { /// 0.6 filter out false dits
#endif
        sym = (sym << 1) | (0);  // insert dit (0)
      }
#ifdef FAIR_WEIGHTING
      if (highduration > (hightimesavg + hightimesavg / 2) && highduration < (hightimesavg * 6)) {
#else
      if (highduration > (hightimesavg * 2) && highduration < (hightimesavg * 6)) {
#endif
        sym = (sym << 1) | (1);  // insert dah (1)
        wpm = (wpm + (1200 / ((highduration) / 3) * 4 / 3)) / 2;
      }
    }

    if (filteredstate == HIGH) { // we did end a LOW
      uint16_t lacktime = 10;
      if (wpm > 25)lacktime = 10; // when high speeds we have to have a little more pause before new letter or new word
      if (wpm > 30)lacktime = 12;
      if (wpm > 35)lacktime = 15;

#ifdef FAIR_WEIGHTING
      if (lowduration > (hightimesavg * (lacktime * 1 / 10)) && lowduration < hightimesavg * (lacktime * 5 / 10)) { // letter space
#else
      if (lowduration > (hightimesavg * (lacktime * 7 / 80)) && lowduration < hightimesavg * (lacktime * 5 / 10)) { // letter space
        //if(lowduration > (hightimesavg*(lacktime*2/10)) && lowduration < hightimesavg*(lacktime*5/10)){ // letter space
#endif
        printsym();
      }
      if (lowduration >= hightimesavg * (lacktime * 5 / 10)) { // word space
        printsym();
        printsym();  // print space
      }
    }
  }

  // write if no more letters
  if ((millis() - startttimelow) > (highduration * 6) && (sym > 1)) {
    printsym();
  }

  filteredstatebefore = filteredstate;
}

#else // OLD_CW

void dec2()
{
  if (filteredstate != filteredstatebefore) { // then we do want to have some durations on high and low
    if (menumode == 0) {
      lcd.noCursor();
      lcd.setCursor(15, 1);
      lcd.print((filteredstate) ? 'R' : ' ');
      stepsize_showcursor();
    }

    if (filteredstate == HIGH) {
      starttimehigh = millis();
      lowduration = (millis() - startttimelow);
      //highduration = 0;

      if ((sym > 1) && lowduration > (hightimesavg * 2)/* && lowduration < hightimesavg*(5*lacktime)*/) { // letter space
        printsym();
        wpm = (1200 / hightimesavg * 4 / 3);
        //if(lowduration >= hightimesavg*(5)){ sym=1; printsym(); } // (print additional space) word space
      }
      if (lowduration >= hightimesavg * (5)) {
        sym = 1;  // (print additional space) word space
        printsym();
      }
    }

    if (filteredstate == LOW) {
      startttimelow = millis();
      highduration = (millis() - starttimehigh);
      //lowduration = 0;
      if (highduration < (2 * hightimesavg) || hightimesavg == 0) {
        hightimesavg = (highduration + hightimesavg + hightimesavg) / 3; // now we know avg dit time (rolling 3 avg)
      }
      if (highduration > (5 * hightimesavg)) {
        hightimesavg = highduration / 3;   // if speed decrease fast ..
        //hightimesavg = highduration+hightimesavg;     // if speed decrease fast ..
      }
      if (highduration > (hightimesavg / 2)) {
        sym = (sym << 1) | (highduration > (hightimesavg * 2)); // dit (0) or dash (1)
#if defined(CW_INTERMEDIATE) && !defined(OLED) && !defined(LCD_I2C) && (F_MCU >= 20000000)
        printsym(false);
#endif
      }
    }
  }

  if (((millis() - startttimelow) > hightimesavg * (6)) && (sym > 1)) {
    //if(((millis() - startttimelow) > hightimesavg*(12)) && (sym > 1)){
    //if(sym == 2) sym = 1; else // skip E E E E E
    printsym();  // write if no more letters
    //sym=0; printsym(); // print special char
    //startttimelow = millis();
  }

  filteredstatebefore = filteredstate;
}
#endif //OLD_CW
#endif  //CW_DECODER

#define F_SAMP_PWM (78125/1)
//#define F_SAMP_RX 78125  // overrun, do not use
#define F_SAMP_RX 62500
//#define F_SAMP_RX 52083
//#define F_SAMP_RX 44643
//#define F_SAMP_RX 39062
//#define F_SAMP_RX 34722
//#define F_SAMP_RX 31250
//#define F_SAMP_RX 28409
#define F_ADC_CONV (192307/2)  //was 192307/1, but as noted this produces clicks in audio stream. Slower ADC clock cures this (but is a problem for VOX when sampling mic-input simulatanously).

#ifdef FAST_AGC
volatile uint8_t agc = 2;
#else
volatile uint8_t agc = 1;
#endif
volatile uint8_t nr = 0;
volatile uint8_t att = 0;
volatile uint8_t att2 = 2;  // Minimum att2 increased, to prevent numeric overflow on strong signals
volatile uint8_t _init = 0;

// Old AGC algorithm which only increases gain, but does not decrease it for very strong signals.
// Maximum possible gain is x32 (in practice, x31) so AGC range is x1 to x31 = 30dB approx.
// Decay time is fine (about 1s) but attack time is much slower than I like.
// For weak/medium signals it aims to keep the sample value between 1024 and 2048.
static int16_t gain = 1024;
inline int16_t process_agc_fast(int16_t in)
{
  int16_t out = (gain >= 1024) ? (gain >> 10) * in : in;
  int16_t accum = (1 - abs(out >> 10));
  if ((INT16_MAX - gain) > accum) gain = gain + accum;
  if (gain < 1) gain = 1;
  return out;
}

// Contribution by Alan, M0PUB: Experimental new AGC algorithm.
// ASSUMES: Input sample values are constrained to a maximum of +/-4096 to avoid integer overflow in earlier
// calculations.
//
// This algorithm aims to keep signals between a peak sample value of 1024 - 1536, with fast attack but slow
// decay.
//
// The variable centiGain actually represents the applied gain x 128 - i.e. the numeric gain applied is centiGain/128
//
// Since the largest valid input sample has a value of +/- 4096, centiGain should never be less than 32 (i.e.
// a 'gain' of 0.25). The maximum value for centiGain is 32767, and hence a gain of 255. So the AGC range
// is 0.25:255, or approx. 60dB.
//
// Variable 'slowdown' allows the decay time to be slowed down so that it is not directly related to the value
// of centiCount.

static int16_t centiGain = 128;
#define DECAY_FACTOR 400      // AGC decay occurs <DECAY_FACTOR> slower than attack.
static uint16_t decayCount = DECAY_FACTOR;
#define HI(x)  ((x) >> 8)
#define LO(x)  ((x) & 0xFF)

inline int16_t process_agc(int16_t in)
{
  static bool small = true;
  int16_t out;

  if (centiGain >= 128)
    out = (centiGain >> 5) * in;         // net gain >= 1
  else
    out = (centiGain >> 2) * (in >> 3);  // net gain < 1
  out >>= 2;

  if (HI(abs(out)) > HI(1536)) {
    centiGain -= (centiGain >> 4);       // Fast attack time when big signal encountered (relies on CentiGain >= 16)
  } else {
    if (HI(abs(out)) > HI(1024))
      small = false;
    if (--decayCount == 0) {             // But slow ramp up of gain when signal disappears
      if (small) {                       // 400 samples below lower threshold - increase gain
        if (centiGain < (INT16_MAX - (INT16_MAX >> 4)))
          centiGain += (centiGain >> 4);
        else
          centiGain = INT16_MAX;
      }
      decayCount = DECAY_FACTOR;
      small = true;
    }
  }
  return out;
}

inline int16_t process_nr_old(int16_t ac)
{
  ac = ac >> (6 - abs(ac)); // non-linear below amp of 6; to reduce noise (switchoff agc and tune-up volume until noise dissapears, todo:extra volume control needed)
  ac = ac << 3;
  return ac;
}

inline int16_t process_nr_old2(int16_t ac)
{
  static int16_t ea1;
  //ea1 = MLEA(ea1, ac, 5, 6); // alpha=0.0156
  ea1 = EA(ea1, ac, 64); // alpha=1/64=0.0156
  //static int16_t ea2;
  //ea2 = EA(ea2, ea1, 64); // alpha=1/64=0.0156

  return ea1;
}

inline int16_t process_nr(int16_t in)
{
  /*
    static int16_t avg;
    avg = EA(avg, abs(in), 64); // alpha=1/64=0.0156
    param_c = avg;
  */

  /*
    int32_t _avg = 64 * avg;
    //  if(_avg > 4) _avg = 4;  // clip
    //  uint16_t brs_avgsq = 1 << (_avg * _avg);
    if(_avg > 14) _avg = 14;  // clip
    uint16_t brs_avgsq = 1 << (_avg);


    int16_t inv_gain;
    if(brs_avgsq > 1) inv_gain = brs_avgsq / (brs_avgsq - 1);  // = 1 / (1 - 1/(1 << (1*avg*avg)) );
    else inv_gain = 32768;*/

  static int16_t ea1;
  ea1 = EA(ea1, in, 1 << (nr - 1) );
  //static int16_t ea2;
  //ea2 = EA(ea2, ea1, inv_gain);

  return ea1;
}
/*
  inline int16_t process_nr(int16_t in)
  {
  // Exponential moving average and variance (Lyons 13.36.2)
  param_b = EA(param_b, in, 1 << 4);  // avg
  param_c = EA(param_c, (in - param_b) * (in - param_b), 1 << 4);  // variance
  }
*/

#define N_FILT 7
//volatile uint8_t filt = 0;
uint8_t prev_filt[] = { 0 , 4 }; // default filter for modes resp. CW, SSB
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
  void loop() {
  busvoltage = ina219.getBusVoltage_V();
  current_mA = ina219.getCurrent_mA();
  power_mW = ina219.getPower_mW();
  Vinc = analogRead(3);
  Vref = analogRead(2);
  SWR = (Vinc + Vref) / (Vinc - Vref);
  Vinc = ((Vinc * 5.0) / 1024.0) + 0.5;
  pwr = ((((Vinc) * (Vinc)) - 0.25 ) * k);
  Eff = (pwr) / ((power_mW) / 1000) * 100;
  if (pwr > 0 ) (pwr = pwr + 0.25);
  lcd.setCursor(0, 0);
  lcd.print("SWR     :1 / P     W");
  lcd.setCursor(4, 0);
  lcd.print(SWR);
  lcd.setCursor(15, 0);
  lcd.print(pwr);

  lcd.setCursor (0, 2);
  //lcd.print ("Vss = ");
  lcd.print(busvoltage);
  lcd.print("V  ");

  lcd.setCursor(8, 2);
  lcd.print (-((current_mA) / 1000));
  lcd.print("A  ");

  lcd.setCursor(15, 2);
  lcd.print((power_mW) / 1000);
  lcd.print("W   ");

  lcd.setCursor(0, 1);
  lcd.print("Efficiency = ");
  lcd.print(Eff);
  lcd.setCursor(17, 1);
  lcd.print("%   ");

  delay(300);
  }
*/
